he-projectile/PID_controller/Mechanics/3D_model/Фланец мотора.PNG

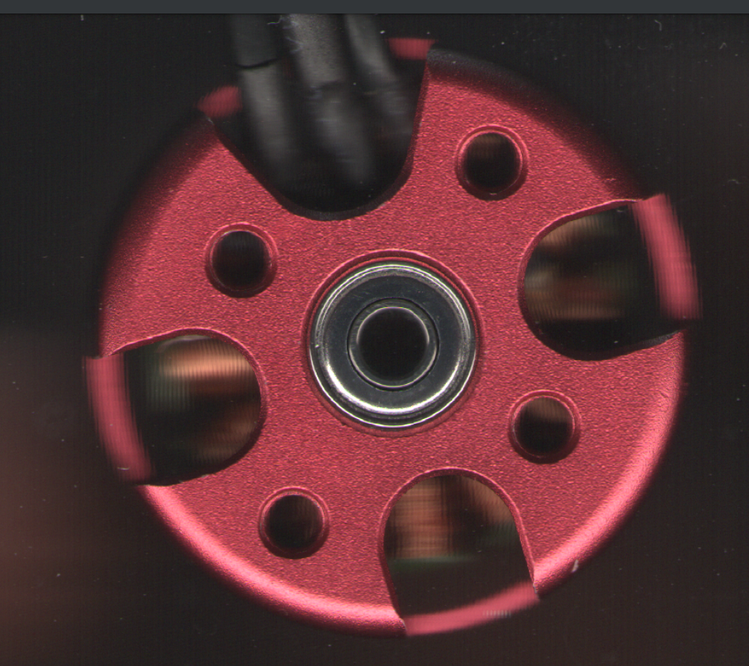
Mechanics/3D_model/Фланец мотора.PNG
