he-projectile/PID_controller/Mechanics/3D_model/Сборка.png

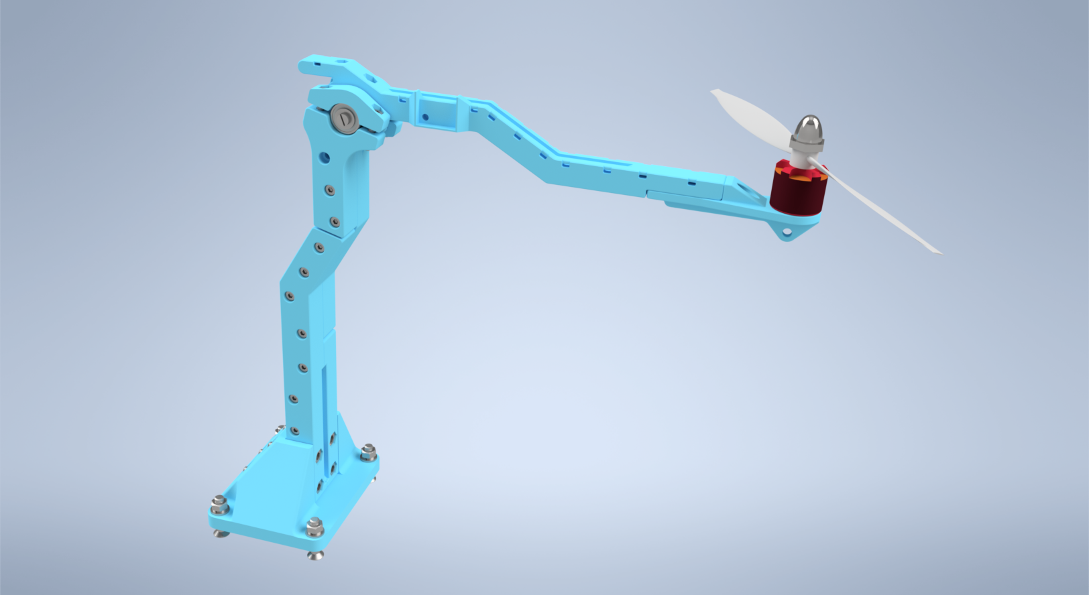
Mechanics/3D_model/Сборка.png
