he-projectile/PID_controller/Mechanics/3D_model/PID_demensions.xlsx

blade_radius | 127
blade_height | 10
bearing_inner | 7
bearing_outer | 19
bearing_width | 6
beam_length | 254
motor_height | 24
motor_diameter | 28
motor_blade_offset | 2
shaft_beam_diameter | 10
M4_screw_innerHex_cap_diam | 6.6
M4_screw_innerHex_cap_height | 4
M4_nut_lock_width | 6.8
M4_nut_lock_height | 5
