he-projectile/PID_controller/Mechanics/3D_model/пример 3д пдф.pdf

setPageBoxes("Crop", 0, 0, [0,2000,2000,0]);
Наименование НОМЕР ДЕТАЛИ | Сборка ВЕРСИЯ Разработал | barko Т. контр. ПРИМЕЧАНИЯ

ПРЕДСТАВЛЕННЫЕ СВЕДЕНИЯ И/ИЛИ МАТЕРИАЛЫ ЯВЛЯЮТСЯ СОБСТВЕННОСТЬЮ АВТОРА ОГРАНИЧЕННОГО ДОСТУПА. ЗАПРЕЩЕНО ИСПОЛЬЗОВАТЬ, ВОСПРОИЗВОДИТЬ, ПУБЛИКОВАТЬ ИЛИ РАСКРЫВАТЬ ЭТИ ДАННЫЕ БЕЗ ПИСЬМЕННОГО РАЗРЕШЕНИЯ. ОНИ ПРЕДНАЗНАЧЕНЫ ТОЛЬКО ДЛЯ РАБОТЫ С ЭЛЕМЕНТАМИ, УКАЗАННЫМИ В ДОКУМЕНТЕ.
