he-projectile/PID_controller/Статья/Ещё_один_пид_контроллеро (2)-теория.pdf

## Теория

В сегодняшней статье расскажу, как на стенде измеряется угол, чем обеспечивается защита от дурака, и как мне помог чатжипити.
Итак, рабочая часть стенда представляет собой неуравновешенную балку с мотором и датчиком, называемыми вместе лучом.Исходное состояние луча - висит вертикально вниз. Тяга пропеллера создаёт момент силы, вращающий луч против часовой стрелки. Примем это направление за положительное, ограниченное углом 170°. В этом диапазоне сила тяжести всегда вращает луч в отрицательном направлении.

Измерение угла
Первостепенная задача - измерение угла отклонения луча от исходной позиции. Затем нужно проверить, что луч вращается в вертикальной плоскости для предотвращения включения стенда в неправильном положении или выключения мотора при заваливании. Первую задачу можно решить при помощи энкодера на оси, а вторую -административно. Но у квадрокоптера нет энкодеров, а аварийные ситуации случаются самопроизвольно. Поэтому буду использовать инерциальный датчик MPU6050 в модуле GY-521.
В одной из статей (https://habr.com/ru/articles/759272/) я описал способ определения ориентации инерциального датчика. Она представляется в виде матрицы 3 × 3, в которой столбцы соответствуют осям датчика, а строки - проекции на север, запад и вертикаль. Казалось бы, прикрепи датчик к балке, посмотри направление оси

−→
z

′

, запомни направление

−→
y

′

, после поворота посчитай угол между прежним и текущим направлением. Но такой вариант доступен только при полной уверенности в том, что ось датчика

−→
z

′ параллельна оси луча, а я не стану гарантировать это.
Поэтому надо обобщить обе операции для случайного закрепления датчика. Как и раньше, алгоритм прототипируется в матлабе. МК обрабатывает данные датчика, вычисляет матрицу и отправляет её компьютеру по USB-CDC в виде массива из 9 байт. При запуске стенда луч неподвижнен. Программа запоминает изначальную ориентацию датчика (M1). Матрица вращается вокруг вектора −→a , и получается матрица M2. Этот вектор и является осью вращения, надо вычислить его. Что мы знаем об −→a ? Его проекции на M1 и M2 одинаковы, при этом матрицы связаны матрицей перехода:

Mtr = M2 · M⁻¹
1
То есть, при применении к −→a линейного оператора Mtr снова выходит −→a . Получается, что −→a является собственным вектором для матрицы перехода. Так как матрица имеет размерность 3, то и собственных векторов тоже 3. Как выбрать нужный? Посчитать

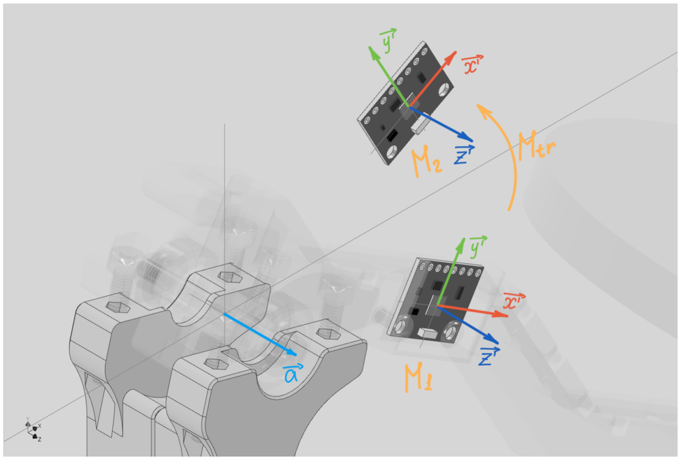
[picture p3: figure]

Рис. 6: Поворот датчика вокруг оси

собственные числа Mtr и выбрать вектор, соответсвующий λ = 1. Почему? Потому что собственное число - это скаляр, который растягивает собственный вектор. При повороте растяжения не происходит, значит λ = 1.
У этого решения есть несколько нюансов. Во-первых, погрешности измерений, расчётов и неровность механики приводят к тому, что Mtr не в полной мере является матрицей поворота, и λ ̸= 1. Поэтому приходится выбирать число наиболее близкое к 1, то есть, равное min(|λ − 1|). Во-вторых, вычисление собственных чисел матрицы - трудоёмкая задача как для микроконтроллера, так и для программиста. Прежде чем кинуться в написание сишных функций, я обратился за советом к чатужипити и не пожалел. Совет 1. Транспонировать матрицу вместо вычисления обратной. Для ортогональной матрицы, к которой относится матрица ориентации, M⁻¹ = MT

. Транспонировать
матрицу проще, и это снизит нагрузку на работу МК.
Совет 2. Использовать след матрицы поворота для вычисления угла.

tr(Mtr) = Mtr(11) + Mtr(22) + Mtr(33) = 1 + 2cos(ψ)

ψ = acos
tr(Mtr) − 1
2

ψ - угол поворота матрицы поворота.
Чтобы программа не ломалась, нужно ограничить значение tr(Mtr) отрезком [-1; 1]. Теоретически, значение следа не должно вылезать за эти границы, но увы, ошибки вычислений. Данный метод возвращает значения от 0 до π, но это не проблема для моего стенда.
Совет 3. Извлекать ось вращения из антисмимметричной части матрцы поворота.

−→a =

1
2sin(ψ)

·

Mtr(32) − Mtr(23)

Mtr(13) − Mtr(31)

Mtr(21) − Mtr(12)

Таким образом, вычисления угла и оси стали быстрыми и непринуждёнными. При запуске стенда необходимо перевести луч из нижнего положения в положение повыше. Из полученных данных будет вычислен вектор оси. Угол между осью и вертикалью должен иметь значение, близкое к 0, 5π. Сильное отклонение приведёт к переходу стенда в аварийное состояние и отключению мотора до перезапуска программы.

Симуляция работы
Прежде чем угробить стенд жёсткими режимами работы, хотелось бы поиграть в математическое моделирование. Может быть, я получу полезный практический опыт или даже готовые коэффициенты ПИД. Для этого составлю уравнение динамики стенда, наишу ПИД-реулатор для управления тягой, абстрагируюсь от задержки измерения угла и изменения тяги, инерции пропеллера.

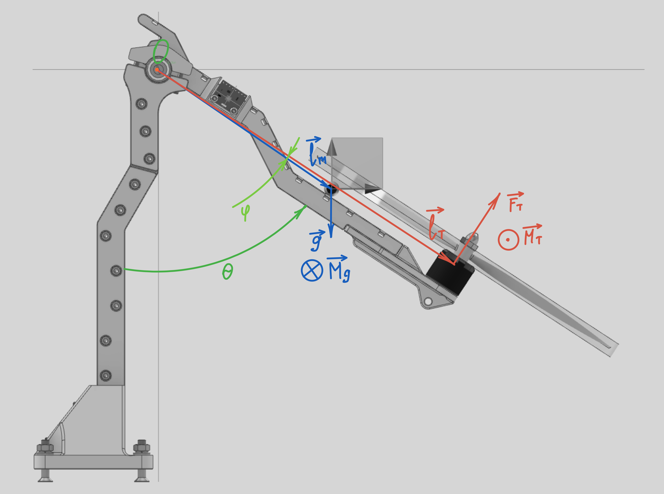
[picture p4: figure]

Рис. 7: Схема действия сил Сила тяжести, действующая на луч и приложенная к центру масс луча, создаёт момент, равный
−→Mg =

−→lg × m
−→g
или

Mg = m · g · lg · sin(θ − φ)
m - масса луча, lg - расстояние от оси O до центра масс луча, θ - угол отклонения луча, φ - угол между лучом и вектором до центра масс.
Так как отклонение луча ограничено 170°, направление момента не меняется. Уравнение статики для этой системы выглядит так:
−→Mg +

−→Mt = 0

или

FT · lT − m · g · lm · sin(θ − φ) = 0
lT - расстояние между осью луча и осью пропеллера, FT - сила тяги пропеллера. При дисбалансе сил возникает угловое ускорение:

FT · lT − m · g · lm · sin(θ − φ) J

= ¨θ

Необходимо добавить сопротивление среды. К ним можно отнести силу трения покоя в подшипнике, силу сухого трения подшипника, силу вязкого сопротивления смазки и силу сопротивления воздуха. Силу сухого трения и трения покоя я исключу, так как хорошо смазал подшипники вэдэшкой. Включим оставшиеся силы и получим уравнение динамики системы.

FT · lT − m · g · lm · sin(θ − φ) − kv

˙θ − ka

˙θ
2
- sign(

˙θ)

J

= ¨θ

J - момент инерции, kv - коэффициент вязкого сопротивления смазки, ka - коэффициент сопротивления воздуха.
Момент инерции и расстояние до центра масс вычислены в САПРе. Для этого я взвесил каждую деталь и прописал массу в физические свойства модели. Равномерность распределения массы по объёму является большим допущением для деталей, напечатанных на FDM-принтере, но это лучшее, что я смог реализовать.
kv и ka - эмпирические коэффициенты. Я получил их значения экспериментально. Для этого закрепил мачту горизонтально, отвёл луч, позволил ему свободно колебаться под действием силы тяжести и получил функцию затухающих колебаний в табличном виде θexp(t). При этом диффур обретает вид

−m·g·lm·sin(θ−φ)−kv

˙θ−ka

˙θ
2
·sign(

˙θ)
J | = ¨θ

θ(0) = −39◦
˙θ = 0
Затем написал матлаб-скрипт, численно решающий приведённый диффур с такими же начальными условиями, как у θexp(t). Обозначу вычисленные данные как θsim(t). Оба графика представлены на рисунке. Как можно увидеть, частоты значительно различаются, примерно в два раза. Она зависит от параметров lm и J. Подобрав ручками J, я понял, что увеличение его вдвое исправляет проблему. После проверки масс всех деталей, я вспомнил, что мой любимый САПР указывает момент инерции относительно центра масс. Чтобы пересчитать значения J для вращения вокруг O, нужно применить теорему Гюйгенса-Штейнера:
J = JC + m · l

2
m
где JC - момент инерции, рассчитанный САПРом.
Отклонение частоты после корректировки уменьшилось до 3%; Теперь можно подобрать kv и ka. Сделать это можно следующим способом. Так как диффур исчерпывающий, можно надеяться, что при правильном выборе kv и ka графики совпадут. Хорошо бы сделать подбор автоматическим и оптимальным по времени. Сперва нужно выбрать

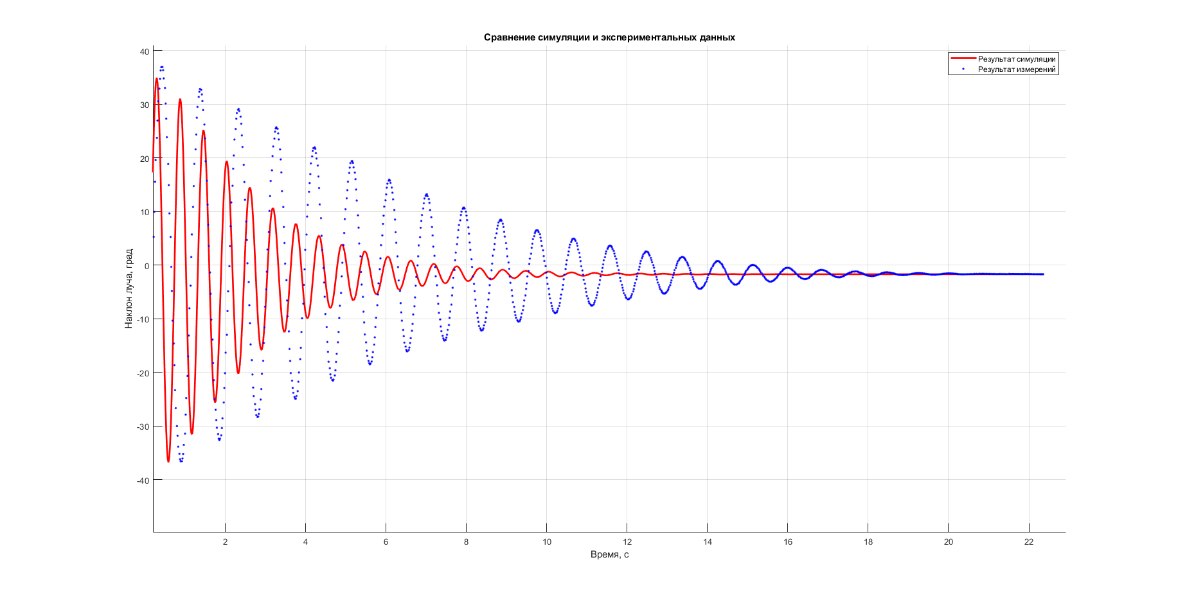
[picture p5: figure]

Рис. 8: Это фиаско

критерий совпадения графиков. Сумма квадратов невязок отлично подходит на роль меры.

RSS =

Xn

τ=0

(θsim(τ ) − θexp(τ ))²

Но вот незадача. Временные метки у θexp(t) и θsim(t) различаются, выбирать пары значений θ с одинаковым аргументом не получится. К тому же, частоты незначительно различаются, на шестнадцатом периоде колебания сдвинуты на 0, 5pi, поэтому RSS никогда не станет равным нулю ( И что? Обоснуй. Мб будет плохо сходиться. Почему?). Однако известно, что kv и ka характеризуют форму огибающей и практически не влияют на период колебаний. Значит можно сравнивать огибающие этих графиков. Для этого из θexp(t) и θsim(t) выделяются пики с помощью функции findpeaks, обозначенные γexp(t) и γsim(t). Затем надо интерполировать γsim(t) функцией interp1 методом сплайн и получить соответствующие значения для временных меток γexp(t). Теперь можно сравнить огибающие. Таким образом вычисление kv и ka сводится к минимизации функции RSS:
RSS(kv, ka) → min
ka,kv∈R²
Для этого используется функция fmincon из пакета Optimization Toolboxt. С начальным приближением kv = 0, ka = 0 решение заняло 16 итераций. Результат можно видеть на графике выше, а полученные значения в таблице.

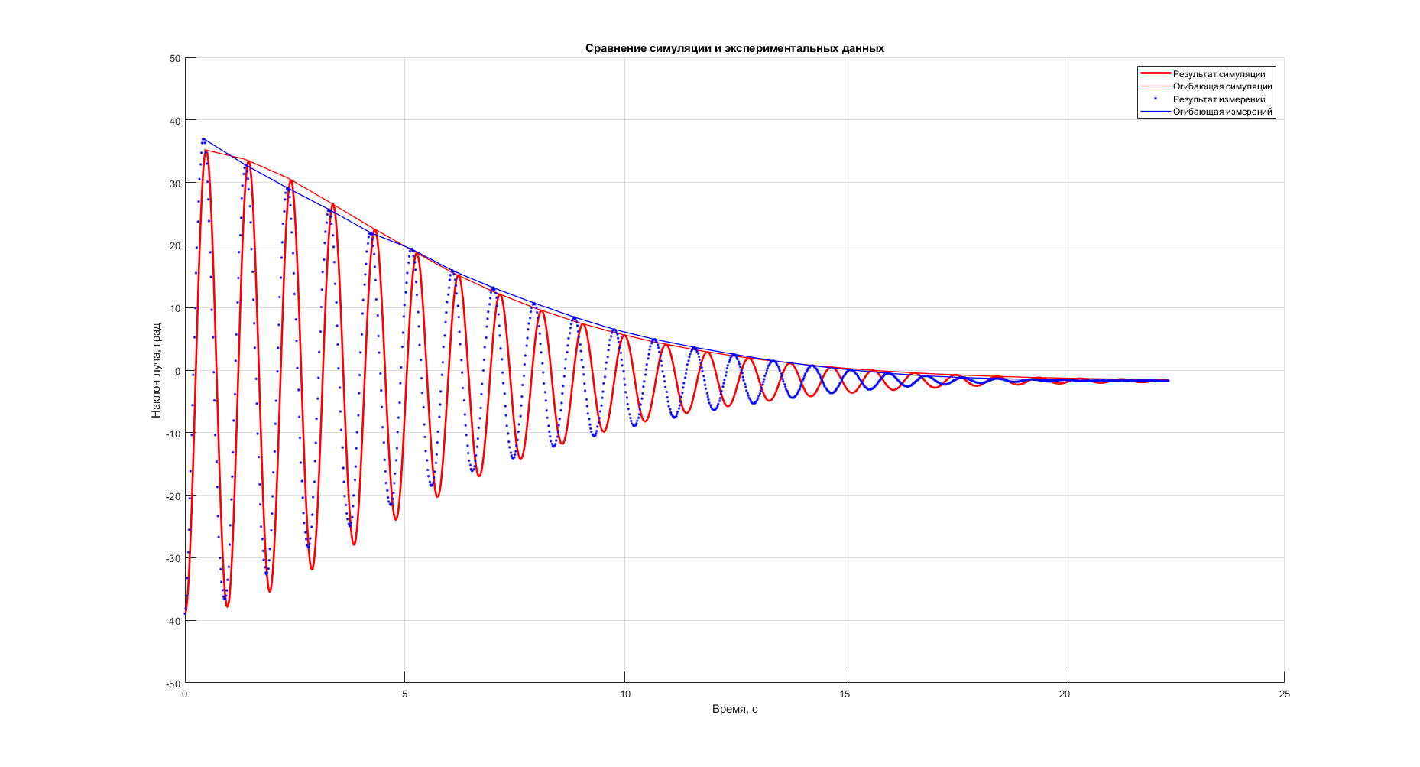
[picture p6: figure]

Рис. 9: Графики отлично накладываются

J, кг·м 2 | 5,52e-3
m, кг | 0,181
lm, м | 0,139
ψ, град | 1,71
kv, попугаи | 1,85e-3
ka, попугаи | 1,06t-3
Теперь можно приступить к моделированию PID-регулятора.
