he-projectile/PID_controller/Статья/Ещё_один_пид_контроллеро-теория.pdf

### Ещё один ПИД-регулятор

Даниил Барков

Лето 2025

## Теория

В сегодняшней статье расскажу, как на стенде измеряется угол, чем обеспечивается защита от дурака, и как мне помог чатжипити.
Итак, рабочая часть стенда представляет собой неуравновешенную балку с мотором и датчиком, называемыми вместе лучом.Исходное состояние луча - висит вертикально вниз. Тяга пропеллера создаёт момент силы, вращающий луч против часовой стрелки. Примем это направление за положительное, ограниченное углом 170°. В этом диапазоне сила тяжести всегда вращает луч в отрицательном направлении.

Измерение угла
Первостепенная задача - измерение угла отклонения луча от исходной позиции. Затем нужно проверить, что луч вращается в вертикальной плоскости для предотвращения включения стенда в неправильном положении или выключения мотора при заваливании. Первую задачу можно решить при помощи энкодера на оси, а вторую -административно. Но у квадрокоптера нет энкодеров, а аварийные ситуации случаются самопроизвольно. Поэтому буду использовать инерциальный датчик MPU6050 в модуле GY-521.
В одной из статей (https://habr.com/ru/articles/759272/) я описал способ определения ориентации инерциального датчика. Она представляется в виде матрицы 3 × 3, в которой столбцы соответствуют осям датчика, а строки - проекции на север, запад и вертикаль. Казалось бы, прикрепи датчик к балке, посмотри направление оси

−→
z

′

, запомни направление

−→
y

′

, после поворота посчитай угол между прежним и текущим направлением. Но такой вариант доступен только при полной уверенности в том, что ось датчика

−→
z

′ параллельна оси луча, а я не стану гарантировать это.
Поэтому надо обобщить обе операции для случайного закрепления датчика. Как и раньше, алгоритм прототипируется в матлабе. МК обрабатывает данные датчика, вычисляет матрицу и отправляет её компьютеру по USB-CDC в виде массива из 9 байт. При запуске стенда луч неподвижнен. Программа запоминает изначальную ориентацию датчика (M1). Матрица вращается вокруг вектора −→a , и получается матрица M2. Этот вектор и является осью вращения, надо вычислить его. Что мы знаем об −→a ? Его проекции на M1 и M2 одинаковы, при этом матрицы связаны матрицей перехода:

Mtr = M2 · M⁻¹
1
То есть, при применении к −→a линейного оператора Mtr снова выходит −→a . Получается, что −→a является собственным вектором для матрицы перехода. Так как матрица имеет размерность 3, то и собственных векторов тоже 3. Как выбрать нужный? Посчитать


Рис. 6: Поворот датчика вокруг оси

собственные числа Mtr и выбрать вектор, соответсвующий λ = 1. Почему? Потому что собственное число - это скаляр, который растягивает собственный вектор. При повороте растяжения не происходит, значит λ = 1.
У этого решения есть несколько нюансов. Во-первых, погрешности измерений, расчётов и неровность механики приводят к тому, что Mtr не в полной мере является матрицей поворота, и λ ̸= 1. Поэтому приходится выбирать число наиболее близкое к 1, то есть, равное min(|λ − 1|). Во-вторых, вычисление собственных чисел матрицы - трудоёмкая задача как для микроконтроллера, так и для программиста. Прежде чем кинуться в написание сишных функций, я обратился за советом к чатужипити и не пожалел. Совет 1. Транспонировать матрицу вместо вычисления обратной. Для ортогональной матрицы, к которой относится матрица ориентации, M⁻¹ = MT

. Транспонировать
матрицу проще, и это снизит нагрузку на работу МК.
Совет 2. Использовать след матрицы поворота для вычисления угла.

tr(Mtr) = Mtr(11) + Mtr(22) + Mtr(33) = 1 + 2cos(ψ)

ψ = acos
tr(Mtr) − 1
2

ψ - угол поворота матрицы поворота.
Чтобы программа не ломалась, нужно ограничить значение tr(Mtr) отрезком [-1; 1]. Теоретически, значение следа не должно вылезать за эти границы, но увы, ошибки вычислений. Данный метод возвращает значения от 0 до π, но это не проблема для моего стенда.
Совет 3. Извлекать ось вращения из антисмимметричной части матрцы поворота.

−→a =

1
2sin(ψ)

·

Mtr(32) − Mtr(23)

Mtr(13) − Mtr(31)

Mtr(21) − Mtr(12)

Таким образом, вычисления угла и оси стали быстрыми и непринуждёнными. При запуске стенда необходимо перевести луч из нижнего положения в положение повыше. Из полученных данных будет вычислен вектор оси. Угол между осью и вертикалью должен иметь значение, близкое к 0, 5π. Сильное отклонение приведёт к переходу стенда в аварийное состояние и отключению мотора до перезапуска программы.

Расчёт параметров модели
Прежде чем угробить стенд жёсткими режимами работы, хотелось бы поиграть в математическое моделирование. Может быть, я получу полезный практический опыт или даже готовые коэффициенты ПИД. Для этого составлю уравнение динамики стенда, наишу ПИД-реулатор для управления тягой, абстрагируюсь от задержки измерения угла и изменения тяги, инерции пропеллера.


Рис. 7: Схема действия сил Сила тяжести, действующая на луч и приложенная к центру масс луча, создаёт момент, равный
−→Mg =

−→lg × m
−→g
или

Mg = m · g · lg · sin(θ − φ)
m - масса луча, lg - расстояние от оси O до центра масс луча, θ - угол отклонения луча, φ - угол между лучом и вектором до центра масс.
Так как отклонение луча ограничено 170°, направление момента не меняется. Уравнение статики для этой системы выглядит так:
−→Mg +

−→Mt = 0

или

0 = FT · lT − m · g · lm · sin(θ − φ)
lT - расстояние между осью луча и осью пропеллера, FT - сила тяги пропеллера. При дисбалансе сил возникает угловое ускорение:

¨θ =

FT · lT − m · g · lm · sin(θ − φ) J
Необходимо добавить сопротивление среды. К ним можно отнести силу трения покоя в подшипнике, силу сухого трения подшипника, силу вязкого сопротивления смазки и силу сопротивления воздуха. Силу сухого трения и трения покоя я исключу, так как хорошо смазал подшипники вэдэшкой. Включим оставшиеся силы и получим уравнение динамики системы.

¨θ =

FT · lT − m · g · lm · sin(θ − φ) − kv

˙θ − ka

˙θ
2
- sign(

˙θ)

J
J - момент инерции, kv - коэффициент вязкого сопротивления смазки, ka - коэффициент сопротивления воздуха.
Момент инерции и расстояние до центра масс вычислены в САПРе. Для этого я взвесил каждую деталь и прописал массу в физические свойства модели. Равномерность распределения массы по объёму является большим допущением для деталей, напечатанных на FDM-принтере, но это лучшее, что я смог реализовать.
kv и ka - эмпирические коэффициенты. Я получил их значения экспериментально. Для этого закрепил мачту горизонтально, отвёл луч, позволил ему свободно колебаться под действием силы тяжести и получил функцию затухающих колебаний в табличном виде θexp(t). При этом диффур обретает вид

¨θ = (−m · g · lm · sin(θ − φ) − kv

˙θ − ka

˙θ
2
- sign(

˙θ)) · J
−1
θ(0) = −39◦
˙θ = 0

Затем написал матлаб-скрипт, численно решающий приведённый диффур с такими же начальными условиями, как у θexp(t). Обозначу вычисленные данные как θsim(t). Оба графика представлены на рисунке. Как можно увидеть, частоты значительно различаются, примерно в два раза. Она зависит от параметров lm и J. Подобрав ручками J, я понял, что увеличение его вдвое исправляет проблему. После проверки масс всех деталей, я вспомнил, что мой любимый САПР указывает момент инерции относительно центра масс. Чтобы пересчитать значения J для вращения вокруг O, нужно применить теорему Гюйгенса-Штейнера:
J = JC + m · l

2
m
где JC - момент инерции, рассчитанный САПРом.
Отклонение частоты уменьшилось до 3%. Теперь можно подобрать kv и ka. Сделать это можно следующим способом. Так как диффур исчерпывающий, можно надеяться, что


Рис. 8: Это фиаско

при правильном выборе kv и ka графики совпадут. Хорошо бы сделать подбор автоматическим и оптимальным по времени. Сперва нужно выбрать критерий совпадения графиков. Сумма квадратов невязок отлично подходит на роль меры.

RSS(kv, ka) = X

N

i=0

(θsim(ti

, kv, ka) − θexp(ti))²

Но вот незадача. Временные метки у θexp(t) и θsim(t) различаются, выбирать пары значений θ с одинаковым аргументом не получится. К тому же, частоты незначительно различаются, на шестнадцатом периоде колебания сдвинуты на 0, 5π, поэтому RSS никогда не станет равным нулю ( И что? Обоснуй. Мб будет плохо сходиться. Почему?). Однако известно, что kv и ka характеризуют форму огибающей и практически не влияют на период колебаний. Значит, достаточно сравнивать огибающие этих графиков. Для этого из θexp(t) и θsim(t) выделяются пики с помощью функции findpeaks, обозначенные γexp(t) и γsim(t). Затем надо интерполировать γsim(t) функцией interp1 методом сплайн, подставить временные метки из θexp(t) и получить соответствующие значения γsimInt(t). Теперь можно сравнить огибающие. Таким образом вычисление kv и ka сводится к минимизации функции RSS:

RSS(kv, ka) = X

N

i=0

(γsimInt(ti

, kv, ka) − γexp(ti))² → min
ka,kv∈R²
Для этого используется функция fmincon из пакета Optimization Toolboxt. С начальным приближением kv0 = 0, ka0 = 0 решение заняло 16 итераций. Результат можно видеть на графике выше, а полученные значения в таблице.


Рис. 9: Графики отлично накладываются

J, кг·м 2 | 5,52e-3
m, кг | 0,181
lm, м | 0,139
ψ, град | 1,71
kv, попугаи | 1,85e-3
ka, попугаи | 1,06е-3

Симуляция PID-регулятора
Наконец, можно приступить к моделированию PID-регулятора. Ограничу задачу достижением и поддержанием угла луча, но в будущем попробую также регулировать скорость вращения луча.
Итак, формула PID-регулятора всем известна.
(
u(t) = KP · err(t) + KI ·

R t
0

err(τ ) dτ − KD ·

derr(t)
dt
err(t) = θset − θ(t)
θset - установочное значение, к которому стремится θ(t). err(t) - ошибка регулирования. u(t) - управляющее воздействие, стремящееся уменьшить ошибку. KP , KI , KD - коэффициенты при пропорциональной, интегральной и дифференциальной составляющей регулятора соответственно. Их значения и определяют работу регулятора, их и предстоит подобрать.

Сперва необходимо врезать в диффур PID-регулятор.

¨θ(t) = (Fmax · u(t) · lT − m · g · lm · sin(θ(t) − φ) − kv ˙θ(t) − ka
˙θ
2
(t) · sign(

˙θ(t))) · J
−1

u(t) ∈ [0, 1]
˙θ(0) = 0

θ(0) = θ0
Fmax - максимальная тяга, которую может выдать мотор. θ0 - Начальный угол Регулятор управляет тягой, которая может быть только положительной и имеет ограничение сверху. Поэтому удобно ограничить также управляющий параметр u(t). Для решения диффура необходимо принять начальные условия ˙θ(0) и θ(0). Регулятор начинает работу при неподвижном опущенном луче, поэтому они равны нулю.
Это дифференциальное уравнение не решается аналитически. Хорошо, что Матлаб может решить его численно. Скрипт выглядит так:
1 | % Parameters
2 | l_m = norm ([138.760 -4.145 ]) /1000*1; | % Distance to the center of
masses (m)
3 | m = 0.181; | % Mass (kg)
4 | psi = atan2 ( -4.145 , 138.760) ; % Rad
5 | J = 2036.662 /10^6+ m * l_m ^2; % kg*m^2
6 | g = 9.81; % m/s^2
7 | kv = 0.0001850;
8 | ka = 0.0001058;
9 | l_T = 0.254;
10 | F_T =10;
11 | alpha = deg2rad (90) ;

12
13 | % Initial conditions
14 | O0 = deg2rad (0) ; | % Initial angle (30 degrees )
15 | omega0 = 0; | % initial angular velocity
16 | integral0 = 0;
17 | Y0 = [ O0 ; omega0 ; integral0 ];

18
19 | % time span
20 | tspan = [0 10];

21
22 | % Solution
23 | [t , Y ] = ode45 ( @ (t , Y ) pendulumODE (t , Y , l_m , m , g , J , psi , kv , ka , F_T ,
l_T , alpha , 0.3 , 0.5 , 0.05 , 0.09) , tspan , Y0 ) ;

24
25 | % Graphics
26 | figure (1) ;
27 | clf ( figure (1) )

28
29 | plot (t , rad2deg ( Y (: ,1) ) , ’r’, ’LineWidth ’, 1.5) ;
30 | xlabel (’Time (c)’) ;
31 | ylabel (’Angle theta ( degree )’) ;
32 | title (’Anle dynamisc ’) ;
33 | ylim ([0 120])
34 | grid on ;
36 | yline ( rad2deg ( alpha ) )

37
38 function dYdt = pendulumODE (t , Y , l , m , g , J , psi , kv , ka , F_T , l_T , alpha , Kp , Ki , Kd , Ks )
39 | if Y (1) >= 0.99* pi
40 | Y (2) = 0;
41 | Y (1) = 0.99* pi;
42 | end
43 | O = Y (1) ; | % Angle theta
44 | omega = Y (2) ; | % Angular velocity dO/dt
45 | e = ( alpha - O ) ;

46
47 | d_integral = e ;

48
49 | if Y (3) >10
50 | Y (3) = 10;
51 | end
52 | if Y (3) < -10
53 | Y (3) = -10;
54 | end
55 | integral = Y (3) ;

56
57 | U = Kp * e+ Ki * integral - Kd * omega + Ks * sin ( alpha ) ;

58
59 | if U >1
60 | U = 1;
61 | end
62 | if U < 0.001
63 | U = 0.001;
64 | end
65 | F = F_T *U ;

66
67 | domegadt = ( F * l_T - m * g * l * sin (O - psi ) - kv * omega *t - ka * omega ^2* sign ( omega ) * t
) / J ;

68
69 | dYdt = [ omega ; domegadt ; d_integral ]; | % Returns vector of derivatives
70 | end
Функция ode45 решает диффур итерациями, поэтому на каждом шаге можно выполнять математические операции над переменными, сравнивать и менять их значения. Это позволяет встроить в диффур различные проверки. Например, на строках 59-64 реализовано ограничение управляющего параметра.
Пора перейти к подбору коэффициентов. Для этого надо
