he-projectile/PID_controller/Mechanics/3D_model/Спецификация.xlsx

Номер | Обозначение | Единичная величина | КОЛ. | Инвентарный номер | Описание | ИЗМ.
8 | Гайка M4-6H ГОСТ 15524-70 | 1 | 7 |  | Гайки шестигранные высокие класса точности А
9 | Винт M4-6gx20 ГОСТ 11738-84 | 1 | 2 |  | ВИНТЫ С ЦИЛИНДРИЧЕСКОЙ ГОЛОВКОЙ И ШЕСТИГРАННЫМ УГЛУБЛЕНИЕМ ПОД КЛЮЧ КЛАССА ТОЧНОСТИ А
11 | Гайка M6-6H ГОСТ 5915-70(1) | 1 | 8 |  | Гайки шестигранные класса точности B удалены и заменены на гайки ГОСТ ISO 4032-2014 и гайки ГОСТ ISO 8673-2014
12 | Винт M6-6gx50 ГОСТ 11738-84 | 1 | 2 |  | ВИНТЫ С ЦИЛИНДРИЧЕСКОЙ ГОЛОВКОЙ И ШЕСТИГРАННЫМ УГЛУБЛЕНИЕМ ПОД КЛЮЧ КЛАССА ТОЧНОСТИ А
13 | Шайба 6 ГОСТ 11371-78 | 1 | 4 |  | ШАЙБЫ
14 | Шайба 6Л ГОСТ 6402-78 | 1 | 4 |  | Шайбы пружинные
15 | Винт 2.M6-6gx30 ГОСТ 17475-80 | 1 | 4 |  | ВИНТЫ С ПОТАЙНОЙ ГОЛОВКОЙ КЛАССОВ ТОЧНОСТИ А И В
16 | ISO 10642 - M3x12 | 1 | 2 |  | Винты с потайной головкой с шестигранным углублением
17 | ISO 10642 - M3x8 | 1 | 4 |  | Винты с потайной головкой с шестигранным углублением
19 | Гайка M4-6H ГОСТ 11860-85 | 1 | 1 |  | ГАЙКИ КОЛПАЧКОВЫЕ КЛАССА ТОЧНОСТИ А
20 | Шайба A 4 ГОСТ 6958-78 | 1 | 2 |  | ШАЙБЫ УВЕЛИЧЕННЫЕ КЛАССЫ ТОЧНОСТИ А И С
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
