he-projectile/PID_controller/Matlab/PID model.bmp

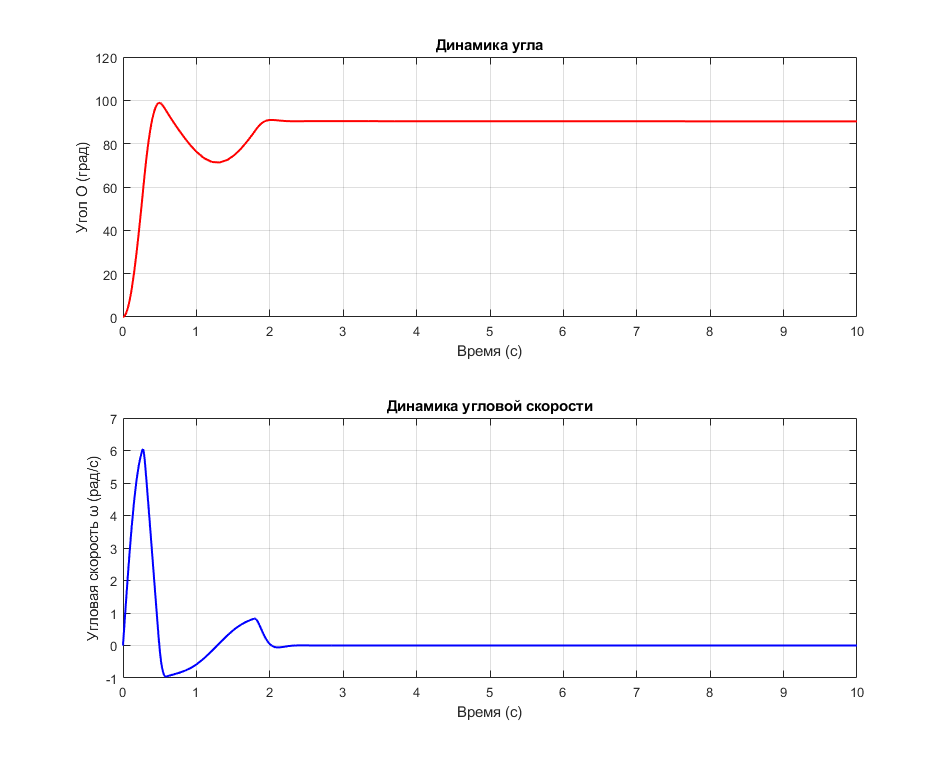
Matlab/PID model.bmp
