he-projectile/PID_controller/Matlab/Диаграмма.PNG

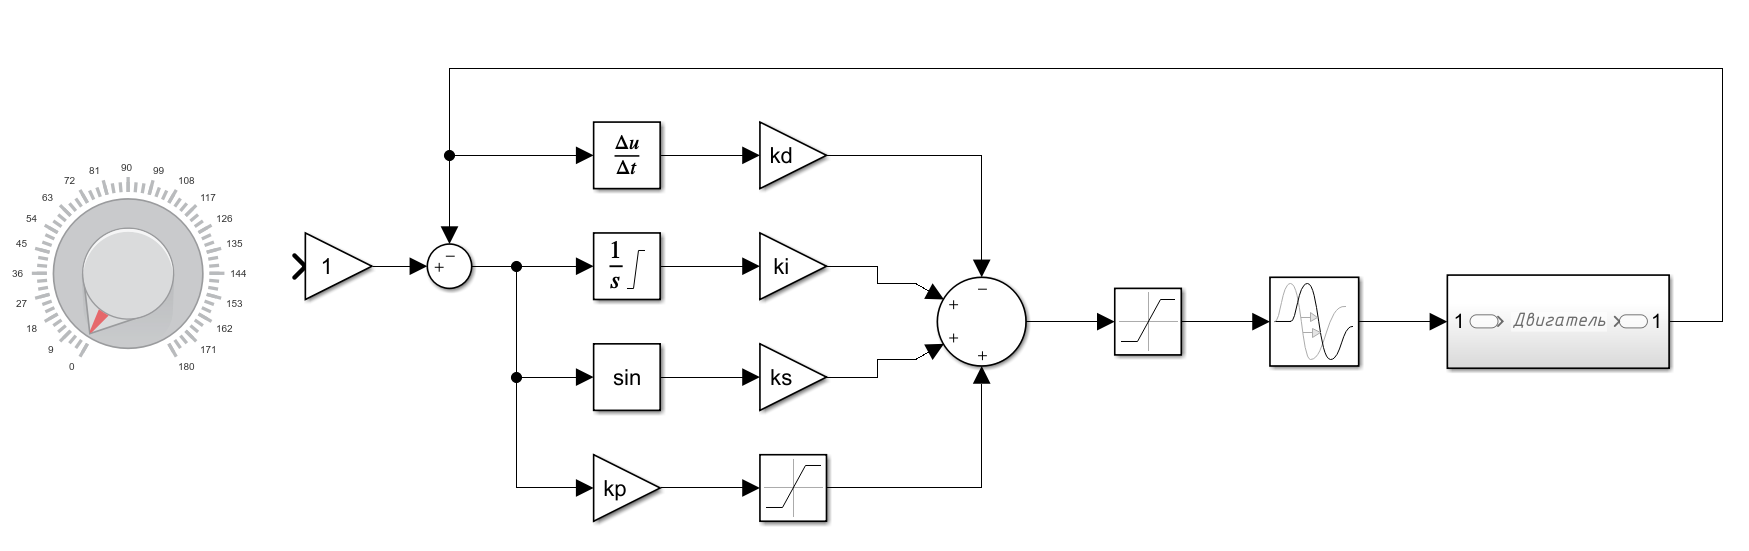
Matlab/Диаграмма.PNG
