he-projectile/PID_controller/Статья/ChatGPT Image 12 июл. 2025 г., 18_17_30.png

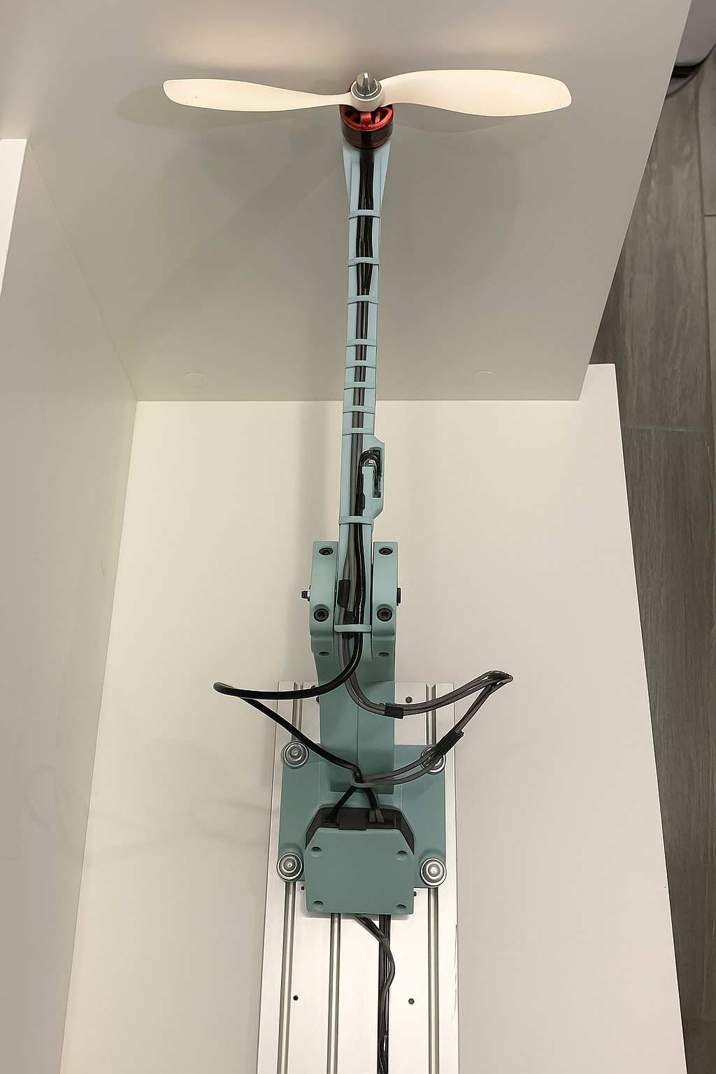
Статья/ChatGPT Image 12 июл. 2025 г., 18_17_30.png
