he-projectile/PID_controller/Статья/PIDfirg.jpg

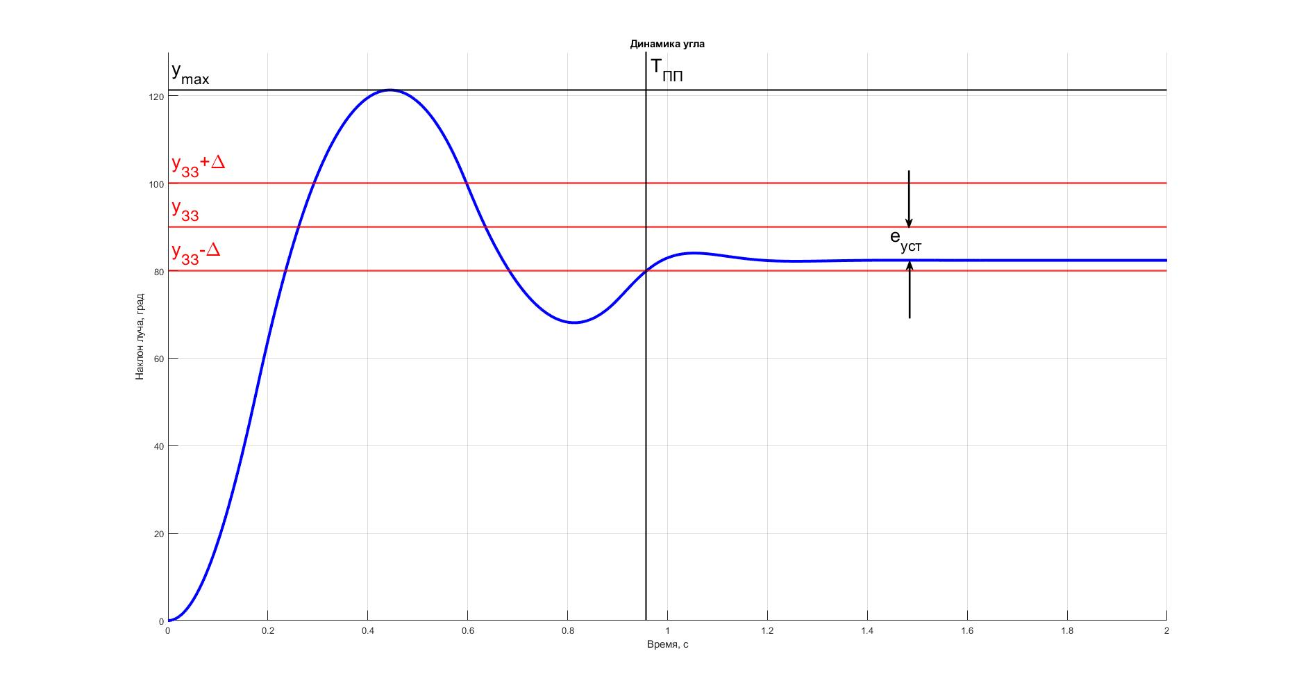
Статья/PIDfirg.jpg
