he-projectile/PID_controller/Статья/Втулка для подшипника.png

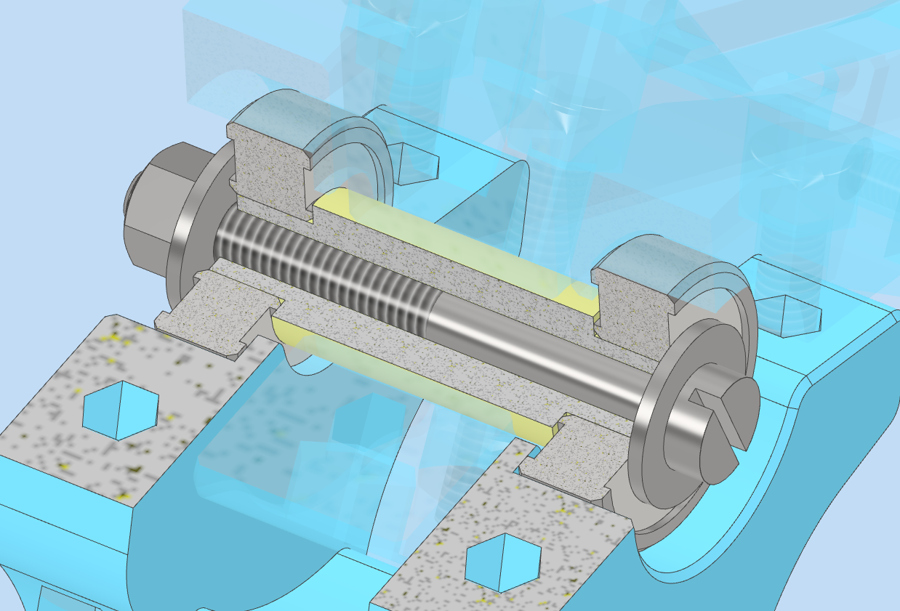
Статья/Втулка для подшипника.png
