he-projectile/PID_controller/Статья/Мемы/kortikozaporot1.jpg

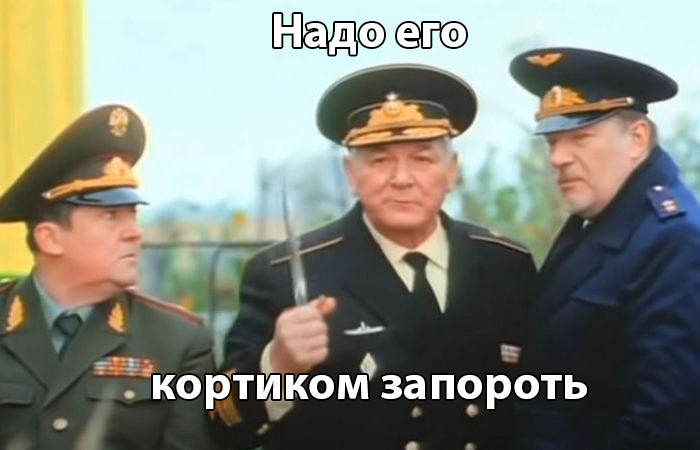
Статья/Мемы/kortikozaporot1.jpg
