he-projectile/PID_controller/Статья/Отверстия для винтов.png

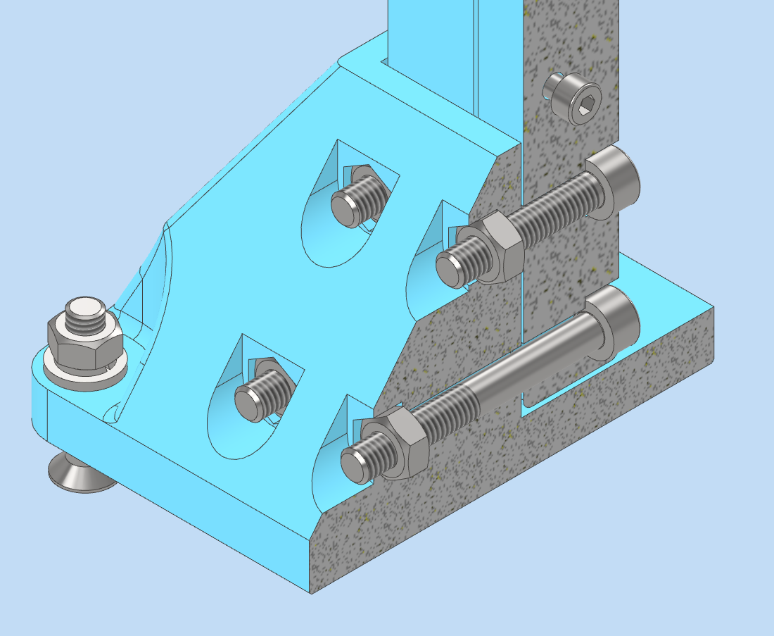
Статья/Отверстия для винтов.png
