he-projectile/PID_controller/Статья/Положение 1 ЧБ.png

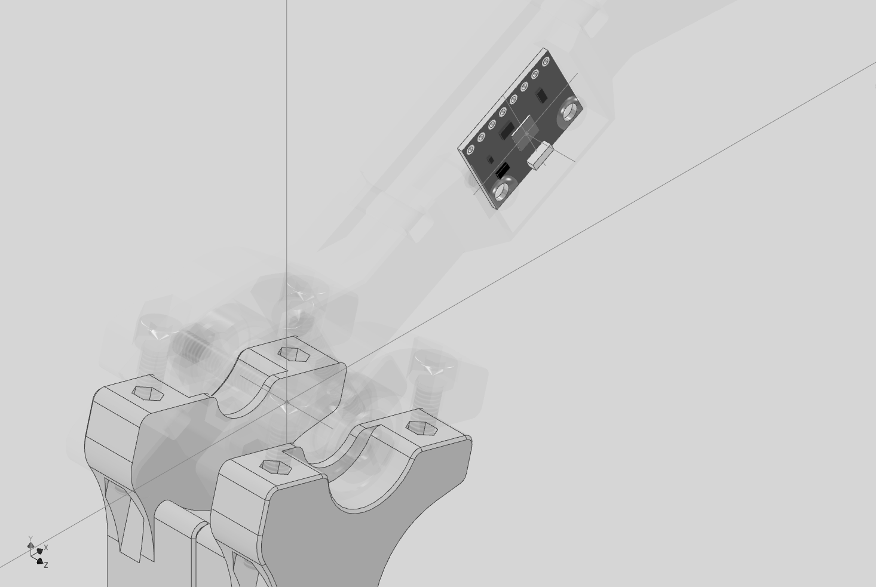
Статья/Положение 1 ЧБ.png
