he-projectile/PID_controller/Статья/Положение 2 ЧБ.png

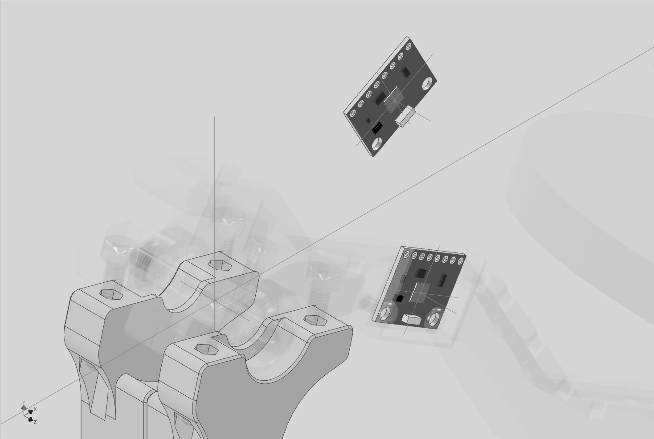
Статья/Положение 2 ЧБ.png
