he-projectile/PID_controller/Статья/Проводка/IMG_0525.JPG

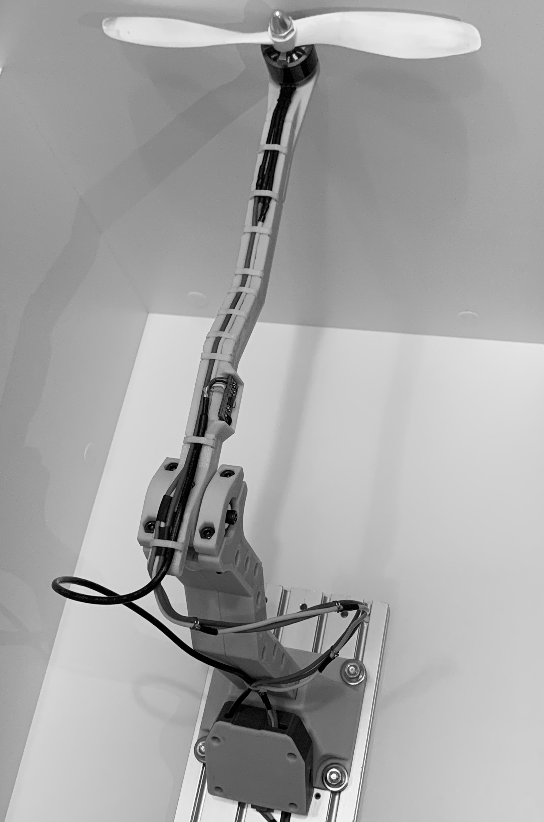
Статья/Проводка/IMG_0525.JPG
