he-projectile/PID_controller/Статья/Проводка/IMG_0526.JPG

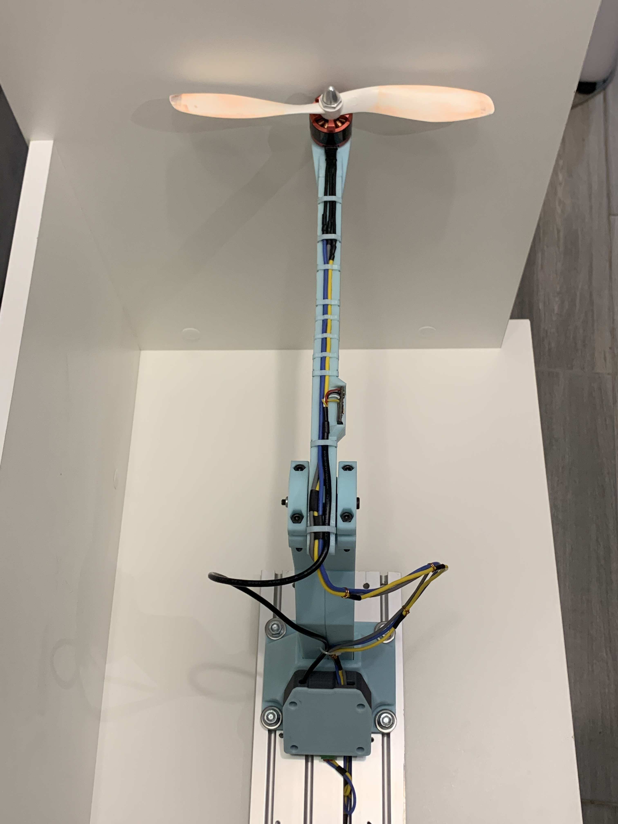
Статья/Проводка/IMG_0526.JPG
