he-projectile/PID_controller/Статья/Проводка/IMG_0527.JPG

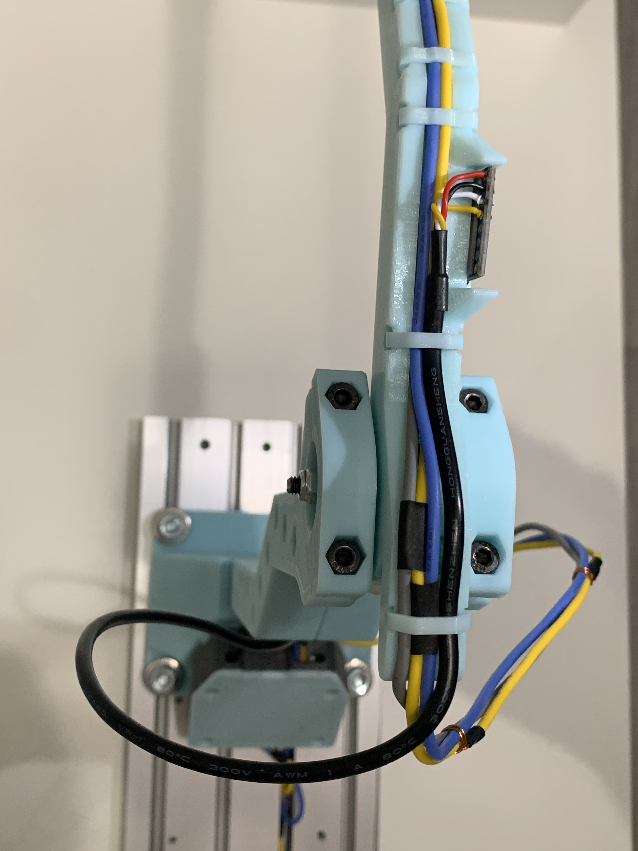
Статья/Проводка/IMG_0527.JPG
