he-projectile/PID_controller/Статья/Проводка/IMG_0528.JPG

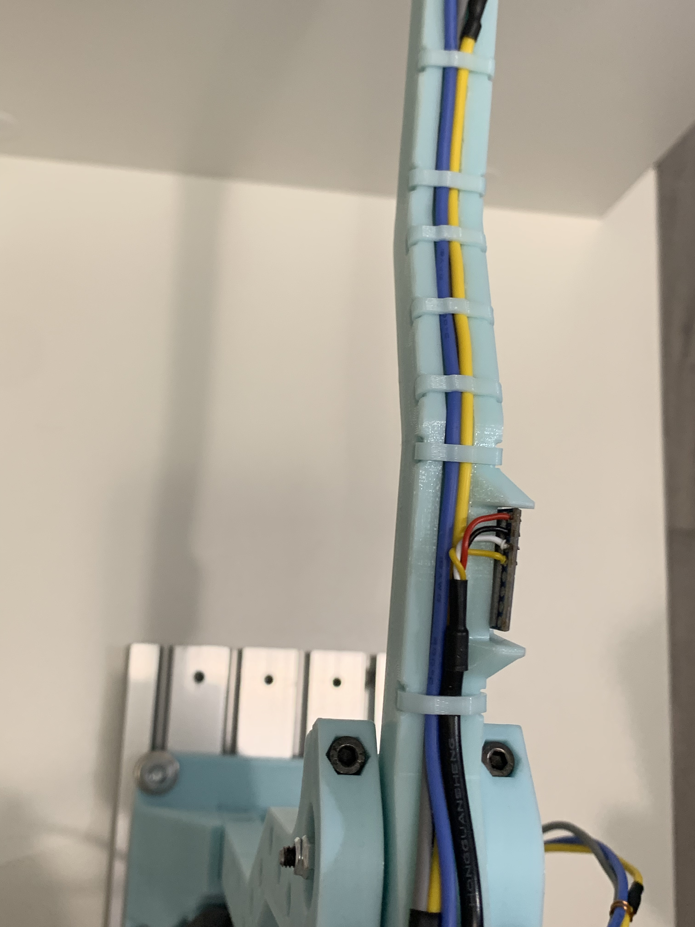
Статья/Проводка/IMG_0528.JPG
