he-projectile/PID_controller/Статья/Проводка/IMG_0529.JPG

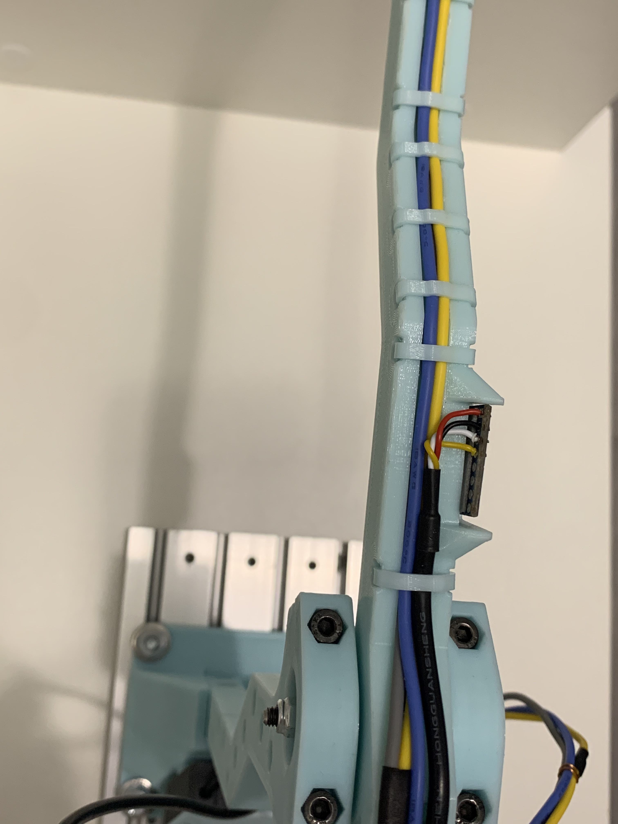
Статья/Проводка/IMG_0529.JPG
