he-projectile/PID_controller/Статья/Проводка/IMG_0530.JPG

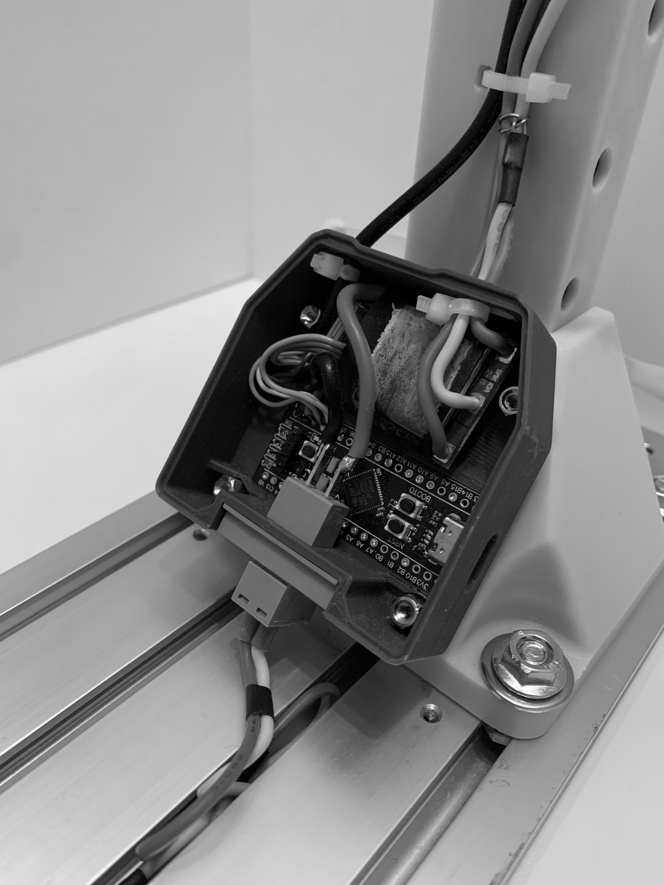
Статья/Проводка/IMG_0530.JPG
