he-projectile/PID_controller/Статья/Результат эскиза.png

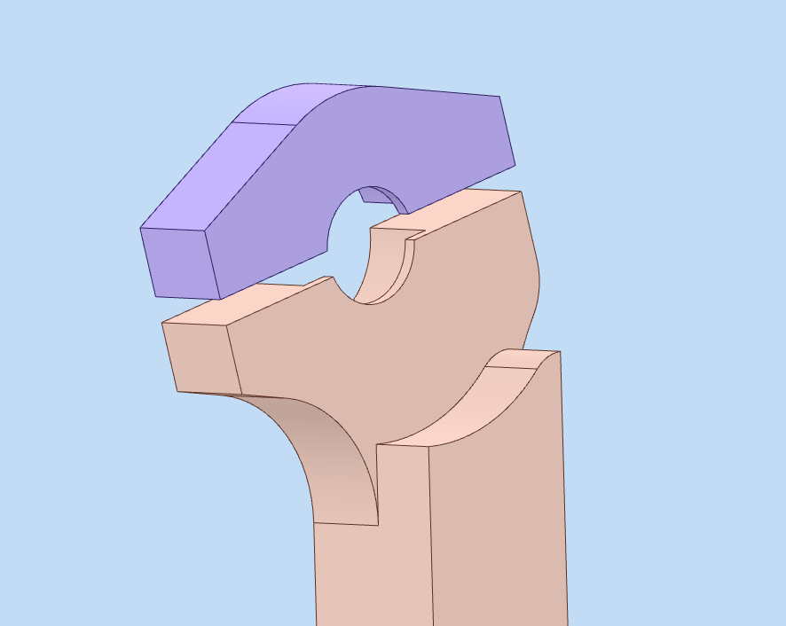
Статья/Результат эскиза.png
