he-projectile/PID_controller/Статья/Сложный эскизpng.png

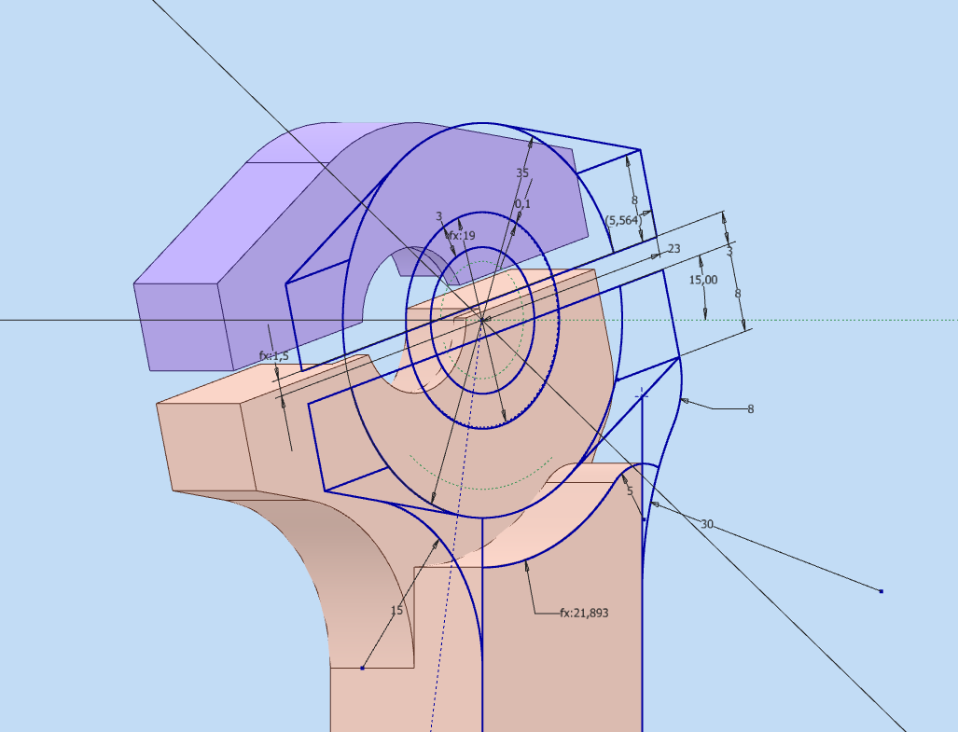
Статья/Сложный эскизpng.png
