he-projectile/PID_controller/Статья/Характеристики процесса.png

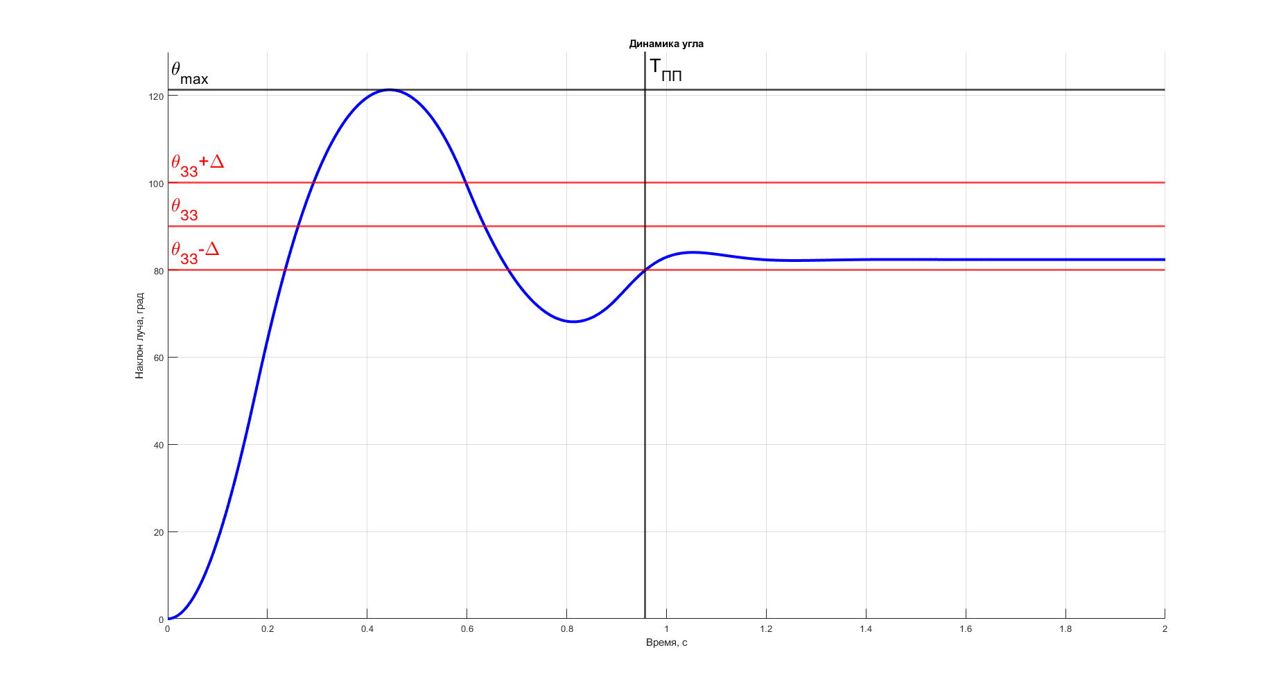
Статья/Характеристики процесса.png
