he-projectile/PID_controller/Статья/Хороший процесс.png

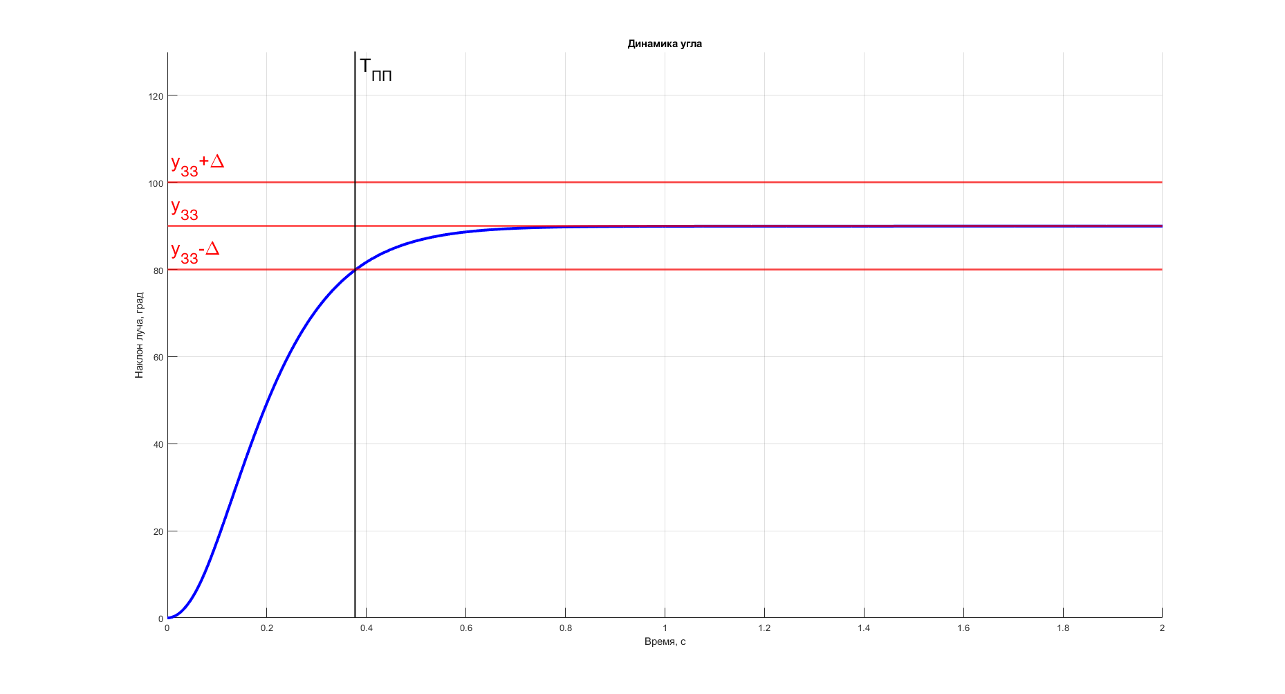
Статья/Хороший процесс.png
