he-projectile/PID_controller/Статья/Эскиз.png

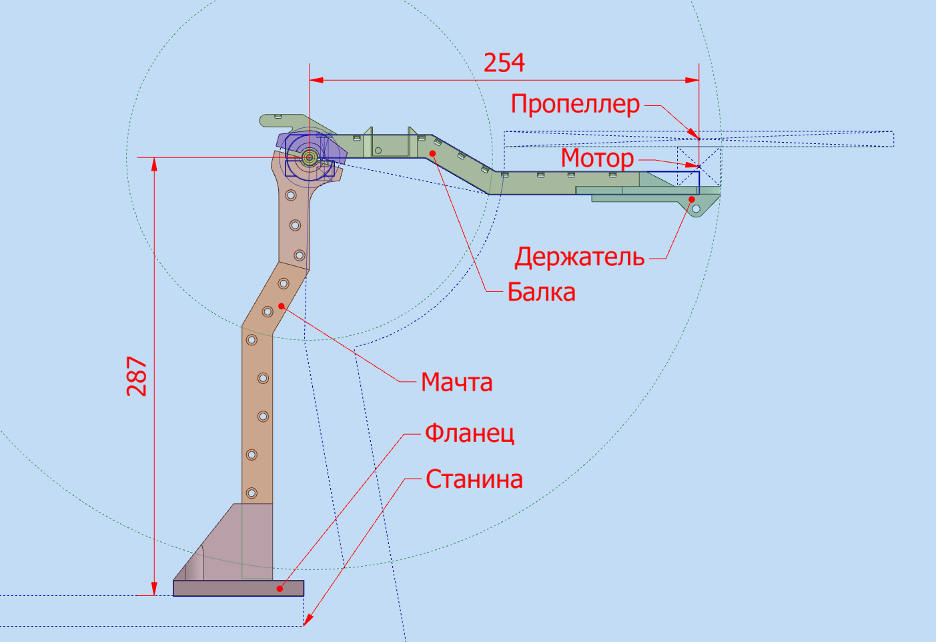
Статья/Эскиз.png
