he-projectile/PID_controller/Matlab/stlModels/stand.stl

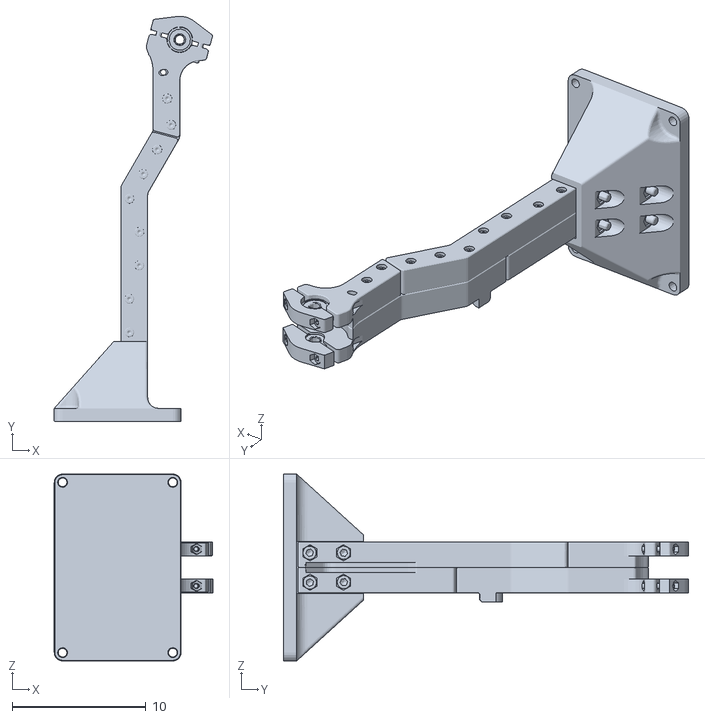
[picture p33: CAD file, 2025-01-03]
Matlab/stlModels/stand.stl
11.9 x 30.3 x 14.0
