he-projectile/PID_controller/Mechanics/3D_model/Файлы печати/Ножка правая низ.stl

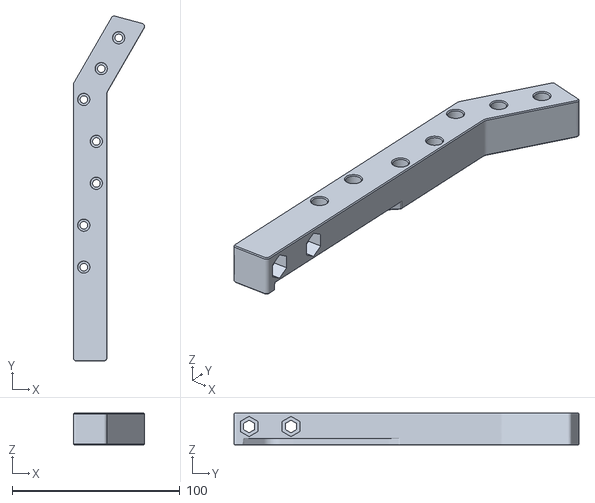
[picture p34: CAD file, 2025-02-20]
Mechanics/3D_model/Файлы печати/Ножка правая низ.stl
42.5 x 205.8 x 19.0
