he-projectile/PID_controller/Mechanics/3D_model/Файлы печати/Ножка правая верх.stl

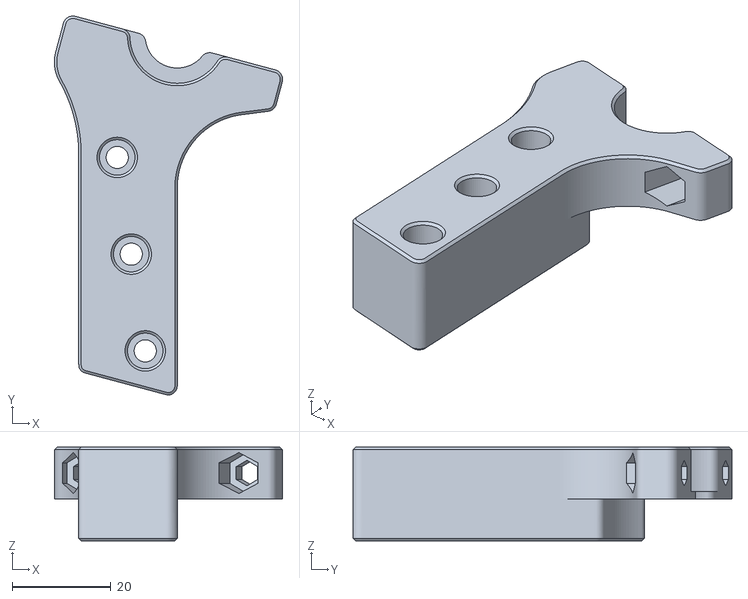
[picture p35: CAD file, 2025-02-20]
Mechanics/3D_model/Файлы печати/Ножка правая верх.stl
46.3 x 76.9 x 19.0
