he-projectile/PID_controller/Mechanics/3D_model/Файлы печати/Ножка левая верх.stl

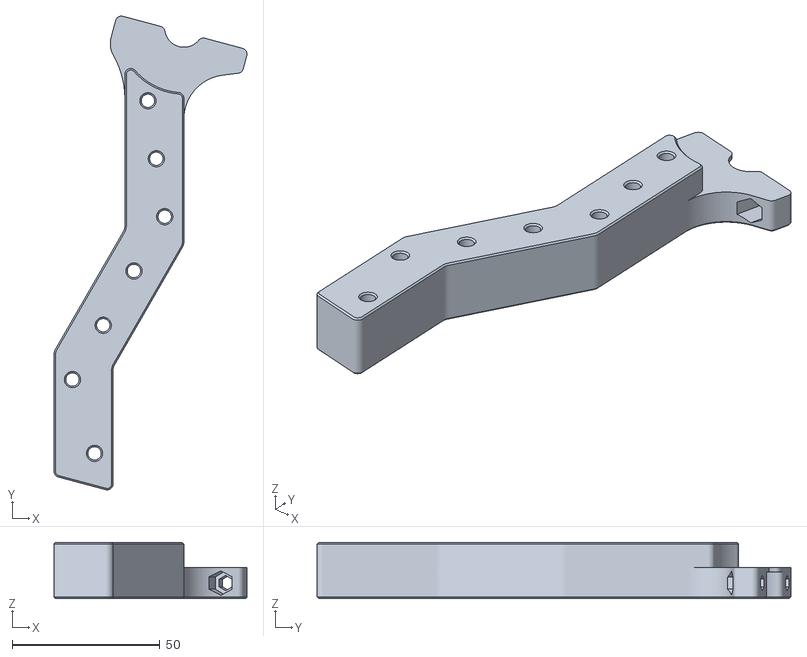
[picture p36: CAD file, 2025-02-20]
Mechanics/3D_model/Файлы печати/Ножка левая верх.stl
65.4 x 160.5 x 19.0
