he-projectile/PID_controller/Mechanics/3D_model/Файлы печати/Вал насадка 1.stl

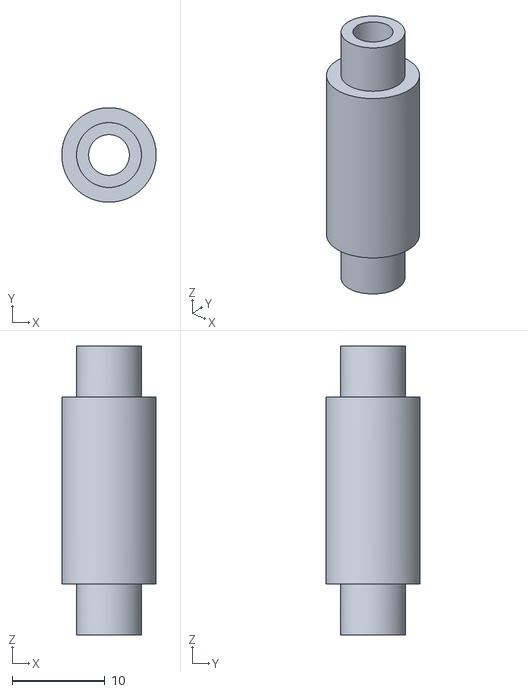
[picture p37: CAD file, 2025-02-20]
Mechanics/3D_model/Файлы печати/Вал насадка 1.stl
10.2 x 10.2 x 31.2
