he-projectile/PID_controller/Mechanics/3D_model/Файлы печати/Луч.stl

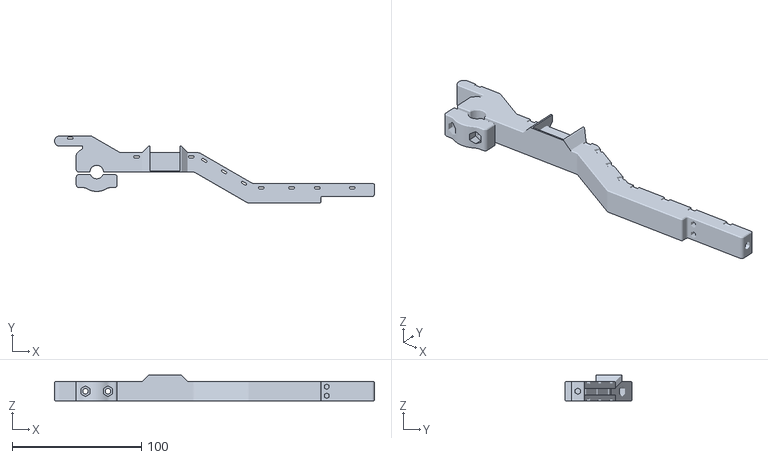
[picture p38: CAD file, 2025-02-20]
Mechanics/3D_model/Файлы печати/Луч.stl
247.7 x 52.0 x 20.0
