he-projectile/PID_controller/Mechanics/3D_model/Файлы печати/Ножка левая низ.stl

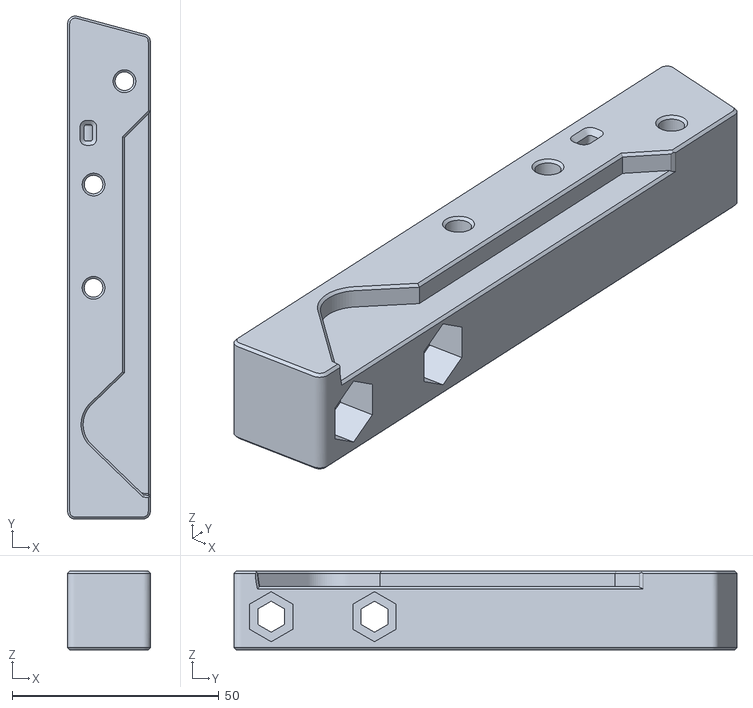
[picture p39: CAD file, 2025-02-20]
Mechanics/3D_model/Файлы печати/Ножка левая низ.stl
20.0 x 121.7 x 19.0
