he-projectile/PID_controller/Mechanics/3D_model/Файлы печати/Ложечка.stl

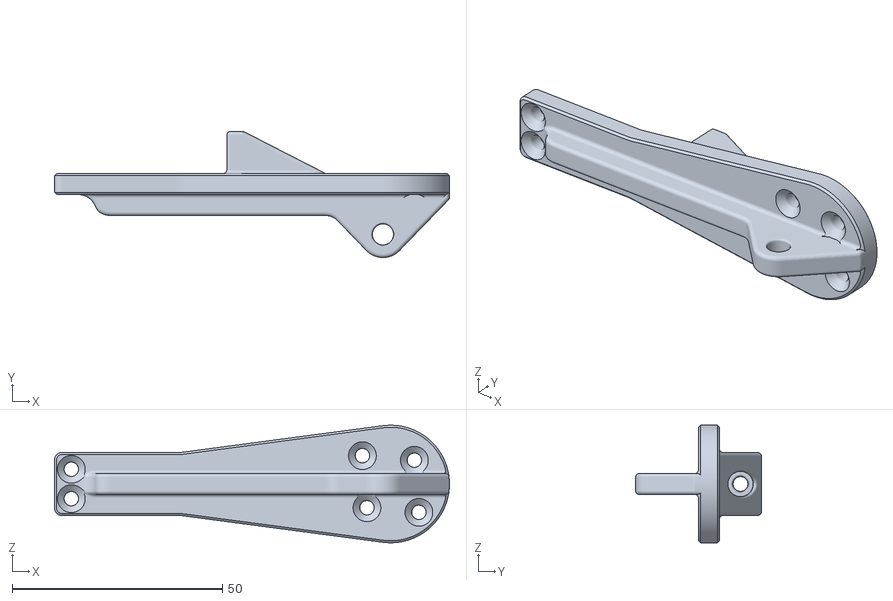
[picture p40: CAD file, 2025-02-20]
Mechanics/3D_model/Файлы печати/Ложечка.stl
94.0 x 30.0 x 28.0
