he-projectile/PID_controller/Mechanics/3D_model/Файлы печати/Скобка 1.stl

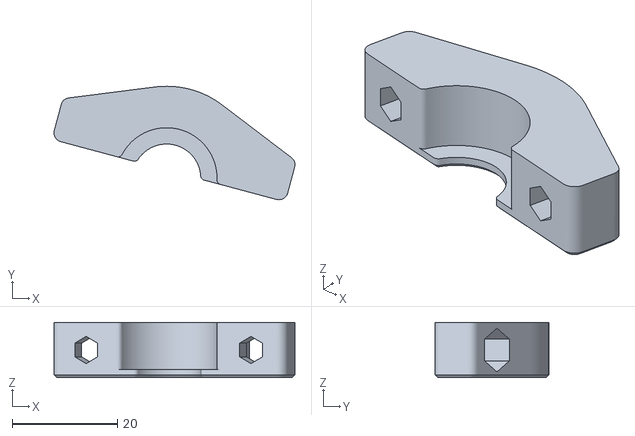
[picture p41: CAD file, 2025-01-01]
Mechanics/3D_model/Файлы печати/Скобка 1.stl
45.9 x 21.6 x 10.5
