he-projectile/PID_controller/Mechanics/3D_model/Файлы печати/Блок.stl

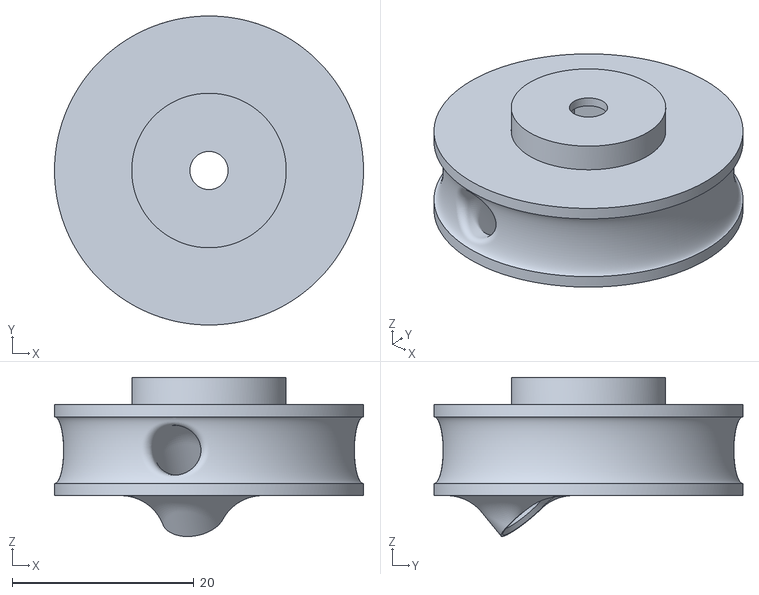
[picture p42: CAD file, 2025-01-01]
Mechanics/3D_model/Файлы печати/Блок.stl
34.0 x 34.0 x 17.5
