he-projectile/PID_controller/Mechanics/3D_model/Файлы печати/Вал насадка.stl

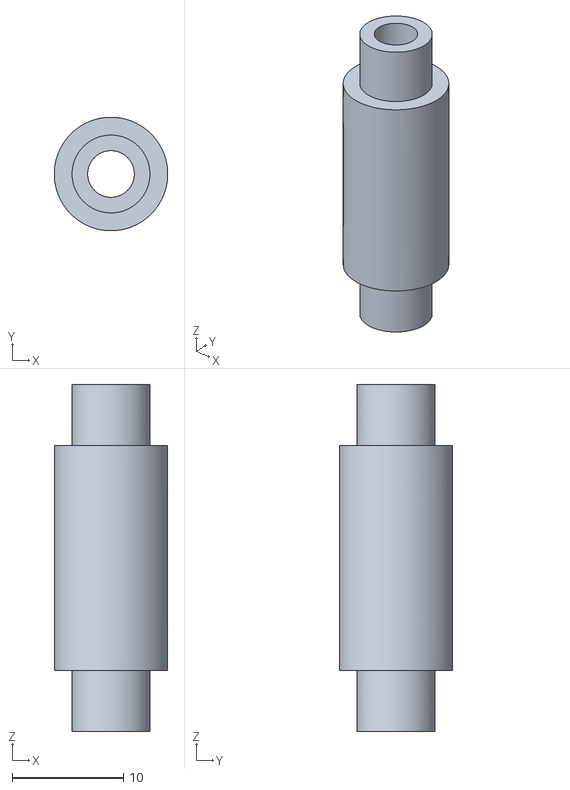
[picture p43: CAD file, 2024-12-10]
Mechanics/3D_model/Файлы печати/Вал насадка.stl
10.2 x 10.2 x 31.2
