he-projectile/PID_controller/Mechanics/3D_model/Файлы печати/Фланец.stl

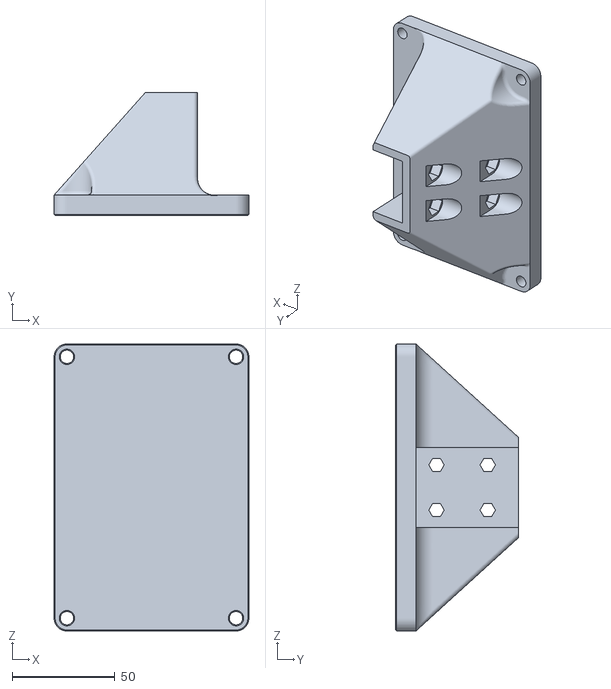
[picture p44: CAD file, 2024-12-09]
Mechanics/3D_model/Файлы печати/Фланец.stl
95.0 x 60.0 x 140.0
