he-projectile/PID_controller/Mechanics/3D_model/Файлы печати/Стрелочка.stl

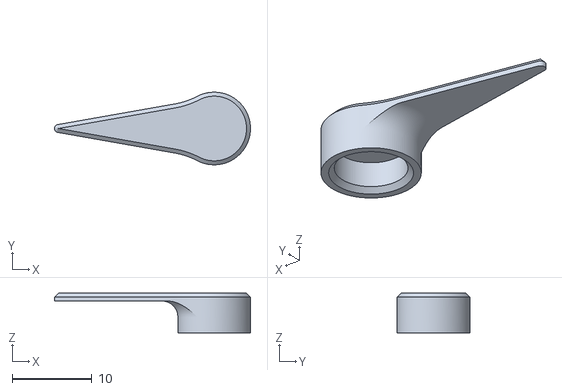
[picture p45: CAD file, 2024-11-30]
Mechanics/3D_model/Файлы печати/Стрелочка.stl
24.6 x 9.10 x 5.00
