he-projectile/PID_controller/Mechanics/3D_model/Файлы печати/Луч обрезанный.stl

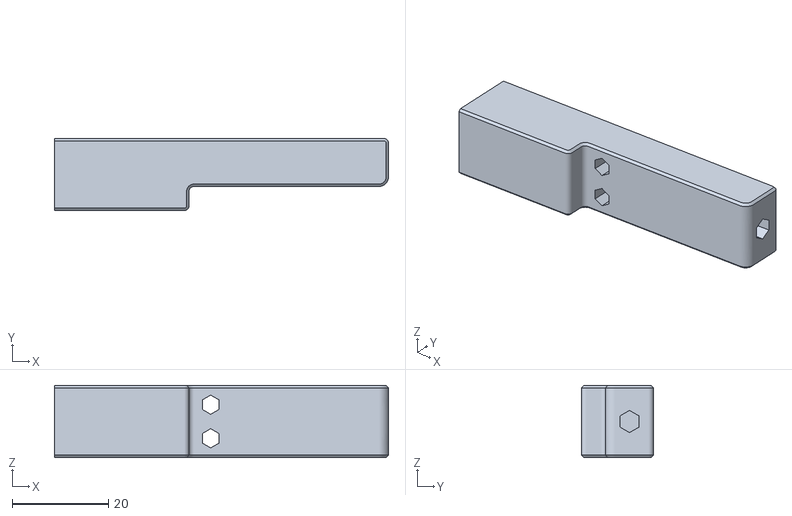
[picture p46: CAD file, 2024-11-26]
Mechanics/3D_model/Файлы печати/Луч обрезанный.stl
69.5 x 15.0 x 15.0
