he-projectile/PID_controller/Mechanics/3D_model/Файлы печати/Ножка 2 обрезанная.stl

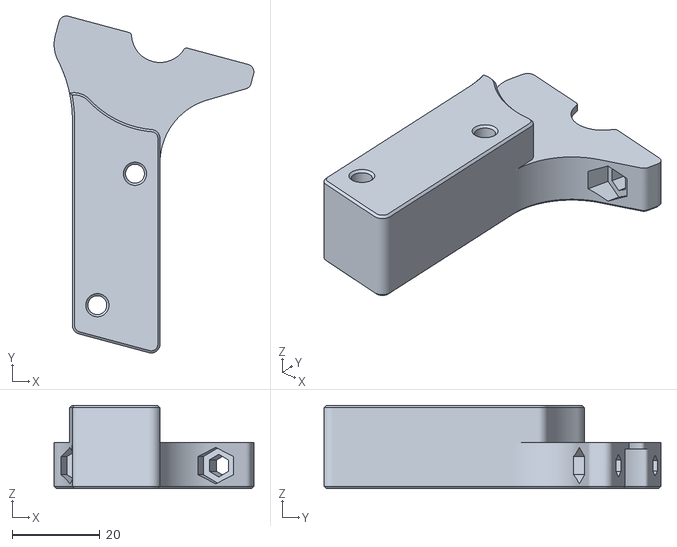
[picture p47: CAD file, 2024-11-25]
Mechanics/3D_model/Файлы печати/Ножка 2 обрезанная.stl
45.6 x 76.9 x 19.0
