he-projectile/PID_controller/Mechanics/3D_model/Файлы печати/Ноэка 1 обрезанная.stl

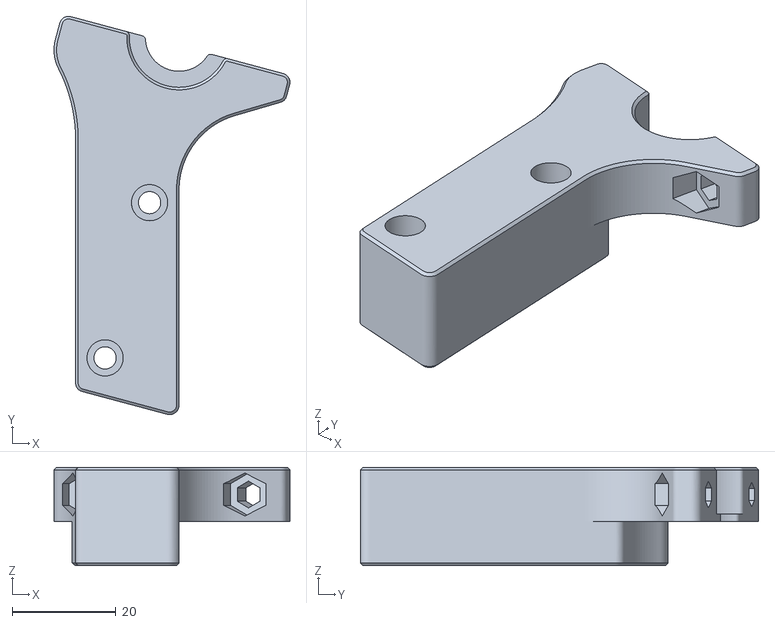
[picture p48: CAD file, 2024-11-25]
Mechanics/3D_model/Файлы печати/Ноэка 1 обрезанная.stl
45.6 x 77.0 x 19.0
