he-projectile/PID_controller/Mechanics/3D_model/Файлы печати/Ножка 1.stl

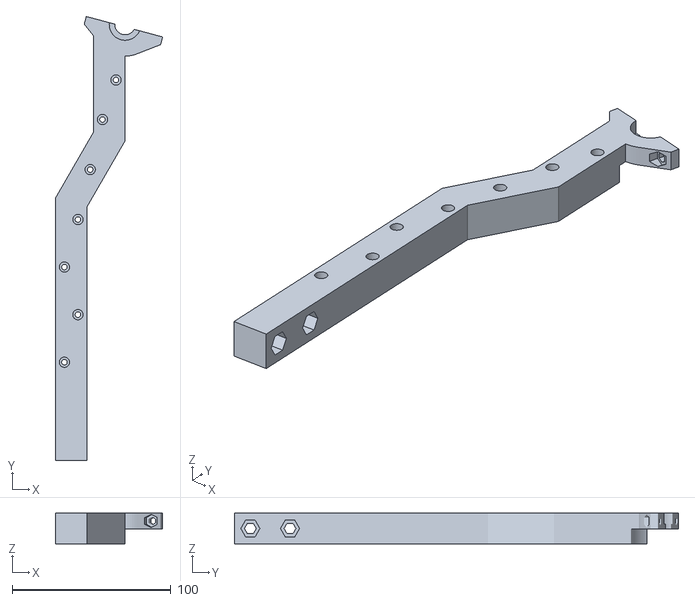
[picture p49: CAD file, 2024-11-21]
Mechanics/3D_model/Файлы печати/Ножка 1.stl
67.7 x 280.0 x 19.5
