he-projectile/PID_controller/(list of files, cad)

Other CAD files:
Mechanics/3D_model/MPU6050.ipt
Mechanics/3D_model/OldVersions/MPU6050.0007.ipt
Mechanics/3D_model/OldVersions/Вал насадка 1.0007.ipt
Mechanics/3D_model/OldVersions/Вал насадка 2.0001.ipt
Mechanics/3D_model/OldVersions/Вал стержень.0002.ipt
Mechanics/3D_model/OldVersions/Ложечка.0014.ipt
Mechanics/3D_model/OldVersions/Луч.0031.ipt
Mechanics/3D_model/OldVersions/Моторчик.0032.ipt
Mechanics/3D_model/OldVersions/Ножка 1.0019.ipt
Mechanics/3D_model/OldVersions/Ножка 2.0018.ipt
Mechanics/3D_model/OldVersions/Подшипник.0016.ipt
Mechanics/3D_model/OldVersions/Провеллер.0001.ipt
Mechanics/3D_model/OldVersions/Пропеллер.0027.ipt
Mechanics/3D_model/OldVersions/Сборка.0102.iam
Mechanics/3D_model/OldVersions/Скобка 1.0012.ipt
Mechanics/3D_model/OldVersions/Скобка 2.0009.ipt
Mechanics/3D_model/OldVersions/Стрелочка.0009.ipt
Mechanics/3D_model/OldVersions/Фланец.0009.ipt
Mechanics/3D_model/OldVersions/Хочу сделать айфичу вставки.0002.ipt
Mechanics/3D_model/Детали твёрдого тела/OldVersions/Блок.0009.ipt
Mechanics/3D_model/Детали твёрдого тела/OldVersions/Вал насадка 1.0023.ipt
Mechanics/3D_model/Детали твёрдого тела/OldVersions/Вал насадка 2.0003.ipt
Mechanics/3D_model/Детали твёрдого тела/OldVersions/Вал стержень.0008.ipt
Mechanics/3D_model/Детали твёрдого тела/OldVersions/Ложечка.0028.ipt
Mechanics/3D_model/Детали твёрдого тела/OldVersions/Луч.0060.ipt
Mechanics/3D_model/Детали твёрдого тела/OldVersions/Ножка 1.0028.ipt
Mechanics/3D_model/Детали твёрдого тела/OldVersions/Ножка 2.0026.ipt
Mechanics/3D_model/Детали твёрдого тела/OldVersions/Ножка левая верх.0011.ipt
Mechanics/3D_model/Детали твёрдого тела/OldVersions/Ножка левая низ.0011.ipt
Mechanics/3D_model/Детали твёрдого тела/OldVersions/Ножка правая верх.0011.ipt
Mechanics/3D_model/Детали твёрдого тела/OldVersions/Ножка правая верх.0012.ipt
Mechanics/3D_model/Детали твёрдого тела/OldVersions/Ножка правая низ.0011.ipt
Mechanics/3D_model/Детали твёрдого тела/OldVersions/Ножка правая низ.0013.ipt
Mechanics/3D_model/Детали твёрдого тела/OldVersions/Скобка 1.0024.ipt
Mechanics/3D_model/Детали твёрдого тела/OldVersions/Скобка 1.0025.ipt
Mechanics/3D_model/Детали твёрдого тела/OldVersions/Скобка 2.0020.ipt
Mechanics/3D_model/Детали твёрдого тела/OldVersions/Стрелочка.0001.ipt
Mechanics/3D_model/Детали твёрдого тела/OldVersions/Фланец.0023.ipt
Mechanics/3D_model/Детали твёрдого тела/Блок.ipt
Mechanics/3D_model/Детали твёрдого тела/Вал насадка 1.ipt
Mechanics/3D_model/Детали твёрдого тела/Вал стержень.ipt
Mechanics/3D_model/Детали твёрдого тела/Ложечка.ipt
Mechanics/3D_model/Детали твёрдого тела/Луч.ipt
Mechanics/3D_model/Детали твёрдого тела/Ножка 1.ipt
Mechanics/3D_model/Детали твёрдого тела/Ножка 2.ipt
Mechanics/3D_model/Детали твёрдого тела/Ножка левая верх.ipt
Mechanics/3D_model/Детали твёрдого тела/Ножка левая низ.ipt
Mechanics/3D_model/Детали твёрдого тела/Ножка правая верх.ipt
Mechanics/3D_model/Детали твёрдого тела/Ножка правая низ.ipt
Mechanics/3D_model/Детали твёрдого тела/Скобка 1.ipt
Mechanics/3D_model/Детали твёрдого тела/Скобка 2.ipt
Mechanics/3D_model/Детали твёрдого тела/Твёрдое тело.iam
Mechanics/3D_model/Детали твёрдого тела/Фланец.ipt
Mechanics/3D_model/Метизы/DIN 912 - M4 x 0,7 x 35 x 20.ipt
Mechanics/3D_model/Метизы/DIN 985 - M4.ipt
Mechanics/3D_model/Метизы/OldVersions/DIN 912 - M4 x 0,7 x 35 x 20.0001.ipt
Mechanics/3D_model/Метизы/OldVersions/Винт M3-6gx8 ГОСТ 11738-84.0001.ipt
Mechanics/3D_model/Метизы/OldVersions/Винт M4-6gx40 ГОСТ 1491-80.0001.ipt
Mechanics/3D_model/Метизы/Винт M3-6gx8 ГОСТ 11738-84.ipt
Mechanics/3D_model/Метизы/Винт M4-6gx40 ГОСТ 11738-84.ipt
Mechanics/3D_model/Метизы/Винт M4-6gx40 ГОСТ 1491-80.ipt
Mechanics/3D_model/Метизы/Гайка M4-6H ГОСТ 11860-85.ipt
Mechanics/3D_model/Метизы/Шайба A 4 ГОСТ 6958-78.ipt
Mechanics/3D_model/Метизы/Шайба У 4Л ГОСТ 6402-78.ipt
Mechanics/3D_model/Моторчик.ipt
Mechanics/3D_model/Подшипник.ipt
Mechanics/3D_model/Пропеллер.ipt
Mechanics/3D_model/Сборка.iam
Mechanics/3D_model/Стрелочка.ipt
Mechanics/3D_model/Твёрдое тело.ipt
Mechanics/3D_model/Тестер втулок.ipt
Mechanics/3D_model/Хочу сделать айфичу вставки.ipt
