he-projectile/PID_controller/MCU/PID_controller_demonstration/Core/Src/main.c

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
/* Includes ------------------------------------------------------------------*/
#include "main.h"
#include "dma.h"
#include "i2c.h"
#include "tim.h"
#include "usb_device.h"
#include "gpio.h"

/* USER CODE BEGIN Includes */
#include <stdio.h>
#include <string.h>
#include <math.h>
#include "MATRIX.h"
#include "MICROS.h"
#include "MPU6050.h"
#include "usbd_cdc.h"
#include "usbd_cdc_if.h"

#include "dsp/fast_math_functions.h"

/* USER CODE END Includes */


/* USER CODE BEGIN PV */


float ACx, ACy, ACz, GYx, GYy, GYz, GYxPrev, GYyPrev, GYzPrev, MAGx, MAGy, MAGz,
	accTotal, gyroTotal, magTotal, 
	beamAngle, beamAngleTau = 0.001;
uint8_t accGyroMagOverload;
const uint16_t PCazimuth = 345;

struct microsPeriod cyclePeriod = {0, 0}, accGyroPeriod = {0, 0}; 				

const uint16_t timMin = 12000, timMax = 24000, timSpan = timMax - timMin;
//float kp = 10, ki = 0.001, kd = 5, ks = 700;
float kp = 1.2964, ki = 2, kd = 0.1604, ks = 700;
float P = 0, I = 0, D = 0, S = 0;
float reqAngle = 90, error = 0;	
float Ilim = 2;
float Plim = 1;
float Dsigma = 45;
float PIDsumTau = 0.001, PIDsum = 0, PIDnormedKoef = 0, PIDsumTmp = 0, thrustPortion = 0;
float accWeight = 2e-04;

MPU6050_DATA_STRUCTURE MPU6050entity1 = {
	.i2cHandle = &hi2c1, .i2cAddress = 0x68<<1,
	.accRawDataBuffer = {0}, .gyroRawDataBuffer = {0},
	.MPU6050state = 0, .overload = 0,
	.accRequestPeriodUs = 10000, .gyroRequestPeriodUs = 2000,
	.accPrevRequestUs = 0, .gyroPrevRequestUs = 0,
	.filterTauUs = 1000, .accPrevFilterUs = 0, .gyroPrevFilterUs = 0,
	.processedDataReady = 0,
	.accDataRequest = 0, .gyroDataRequest = 0,
	.compensatorACx = {1, 0}, .compensatorACy = {1, 0}, .compensatorACz = {1, 0}, 
	.compensatorGYx = {1, 0}, .compensatorGYy = {1, 0}, .compensatorGYz = {1, 0}, 
	.ACx = 0, .ACy = 0, .ACz = 0, .GYx = 0, .GYy = 0, .GYz = 0
	#ifdef DEBUG	
	, .accMesCnt = 0, .gyroMesCnt = 0,.initMicros = 0
	#endif
};


#define RX_BUF_SIZE 64
const uint8_t RxBufSize = RX_BUF_SIZE;
uint8_t RxBuf[RX_BUF_SIZE], protectFromWrite = 0, RxPayload[RX_BUF_SIZE];

typedef enum{
	STAGE_DEINIT = 0,
	STAGE_WAITING_FOR_START,
	STAGE_PREPARING,
	STAGE_RUNNING,
	STAGE_STOPPING,
	STAGE_RESTART,
} STAGES;
STAGES stage;

typedef enum{
	COMMAND_NONE,
	COMMAND_RESTART,
	COMMAND_RUN,
	COMMAND_STOP,
	COMMAND_CHANGE_VALUE	
} COMMAND;
COMMAND command;

/* USER CODE END PV */

void SystemClock_Config(void);
/* USER CODE BEGIN PFP */
void transmitBasis(float* floatArray, uint64_t time, uint8_t overload);
void transmitBeamAngle(float angle, float P, float I, float D, uint64_t time);
void initState(struct matrix *basis, struct matrix *gravity, struct matrix* north);
void restoreVertical(struct matrix* bas, struct matrix* grav, struct matrix* acc);
void PID(uint64_t time);
/* USER CODE END PFP */

/**
  * @brief  The application entry point.
  * @retval int
  */
int main(void)
{
  /* MCU Configuration--------------------------------------------------------*/

  /* Reset of all peripherals, Initializes the Flash interface and the Systick. */
  HAL_Init();

  /* Configure the system clock */
  SystemClock_Config();

  /* Initialize all configured peripherals */
  MX_GPIO_Init();
  MX_I2C1_Init();
  MX_DMA_Init();
  MX_TIM4_Init();
  MX_USB_DEVICE_Init();
  MX_TIM3_Init();
  /* USER CODE BEGIN 2 */
	microsInit(&htim3, 72000000);	// start micros timer
	
	htim4.Instance->PSC = 5;
	htim4.Instance->ARR = 48000;
	htim4.Instance->CCR2 = 0;		
	HAL_TIM_PWM_Start(&htim4, TIM_CHANNEL_2);
//	HAL_Delay(1000);
//	htim4.Instance->CCR2 = 1000;
	
	// startup the sensor, assign pointers of ACC, GYRO, MAG and overload flag variables	
	MPU6050setup(&MPU6050entity1);
	
	struct matrix accVec,	gyroVec, magVec, rotMatrix, basis, gravityVec, northVec, velocityVec, coordinate, basisStep1, basisStep1Inv, plug, transitionMatrix;
	
	matrixZeroes(&accVec , 3, 1);
	matrixZeroes(&gyroVec , 3, 1);
	matrixZeroes(&magVec , 3, 1);
	matrixZeroes(&rotMatrix , 3, 3);
	matrixEye(&basis, 3);
	matrixZeroes(&gravityVec, 3,1);
	matrixZeroes(&northVec, 3, 1);
	matrixZeroes(&velocityVec, 3,1);
	matrixZeroes(&coordinate, 3, 1);
	matrixZeroes(&basisStep1, 3, 3);
	matrixZeroes(&basisStep1Inv, 3, 3);
	matrixZeroes(&plug, 3, 3);
	matrixZeroes(&transitionMatrix, 3, 3);
	
	matrixSE(&northVec, 0, 0, 1);
//	matrixRotZ(&northVec, PCazimuth);
	// indication before the ongoing calibration. Sensor should be kept still!
	HAL_Delay(500);
	for(uint8_t v = 0; v<10; v++){
		HAL_GPIO_TogglePin(LED_GPIO_Port, LED_Pin);
		HAL_Delay(150);
	}
	HAL_GPIO_WritePin(LED_GPIO_Port, LED_Pin, GPIO_PIN_RESET);
	HAL_Delay(1000);
	HAL_GPIO_WritePin(LED_GPIO_Port, LED_Pin, GPIO_PIN_SET);
	
	gyroMeasureOffset(&MPU6050entity1);
	microsStart(&accGyroPeriod);	
	htim4.Instance->CCR2 = 12000;
	
  /* USER CODE END 2 */

  /* Infinite loop */
  /* USER CODE BEGIN WHILE */
	
  while (1)
  {
		static float periodS;
		static uint32_t ledToggleCnt = 0;
		static uint8_t newAngleReady = 0;
			
		switch (stage){
			case STAGE_DEINIT:{
				initState(&basis, &gravityVec, &northVec);
				
				matrixCopy(&basis, &basisStep1);
				matrixInvOrth(&basisStep1, &basisStep1Inv);				
				stage = STAGE_WAITING_FOR_START;
			} break;
			case STAGE_WAITING_FOR_START:{
				if (HAL_GPIO_ReadPin(KEY_GPIO_Port, KEY_Pin) == GPIO_PIN_RESET)
					stage = STAGE_PREPARING;						
			} break;
			case STAGE_PREPARING:{
				static uint8_t isPreparing = 0;
				static uint64_t prepatingStartTime = 0;
				if ( isPreparing == 0){
					isPreparing = 1;
					prepatingStartTime = micros();
					htim4.Instance->CCR2 = 13050;
				}	
				else if (micros() - prepatingStartTime > 10000000){
					isPreparing = 0;
					stage = STAGE_RUNNING;		
				}
			} break;			
			case STAGE_RUNNING:{	
				if (newAngleReady){
					PID(micros());
					newAngleReady = 0;
				}
			} break;
			case STAGE_STOPPING:{
				static uint8_t isStopping = 0;
				static uint64_t stoppingTime = 0;
				if ( isStopping == 0){
					isStopping = 1;
					stoppingTime = micros();
				}	
				else if (micros() - stoppingTime > 10000){
					stoppingTime = micros();
					htim4.Instance->CCR2 -= 5;
				}
				if (htim4.Instance->CCR2 < 13050){
					stage = STAGE_WAITING_FOR_START;
					isStopping = 0;
				}
			} break;
			case STAGE_RESTART:{
				static uint8_t isRestarting = 0;
				static uint64_t restartingTime = 0;
				if ( isRestarting == 0){
					isRestarting = 1;
					htim4.Instance->CCR2 = 12000;
					restartingTime = micros();
				} else if (micros() - restartingTime > 10000000){
					isRestarting = 0;
					stage = STAGE_DEINIT;
				}
			}break;
		};
			
		MPU6050_cycle(&MPU6050entity1, micros());		
		
		if ( MPU6050_ACC_isReady(&MPU6050entity1) == 1 ){	
			matrixSE(&accVec, 0, 0, MPU6050entity1.ACx);
			matrixSE(&accVec, 1, 0, MPU6050entity1.ACy);
			matrixSE(&accVec, 2, 0, MPU6050entity1.ACz);
			accTotal = matrixVecLen(&accVec);
			
			matrixMultiply(&basis, &accVec, &accVec);
			restoreVertical(&basis, &gravityVec, &accVec);
			matrixSum(&accVec, &gravityVec, &accVec);						
		}

		if ( MPU6050_ACC_isReady(&MPU6050entity1) == 1 ){	
			matrixSE(&accVec, 0, 0, MPU6050entity1.ACx);
			matrixSE(&accVec, 1, 0, MPU6050entity1.ACy);
			matrixSE(&accVec, 2, 0, MPU6050entity1.ACz);
			accTotal = matrixVecLen(&accVec);
			
			matrixMultiply(&basis, &accVec, &accVec);
			restoreVertical(&basis, &gravityVec, &accVec);
			matrixSum(&accVec, &gravityVec, &accVec);						
		}
		
		
		
		if( MPU6050_GYRO_isReady(&MPU6050entity1) == 1){
			float GYxTmp, GYyTmp, GYzTmp;
			float beamAngleTmp;
			
			microsUpdate(&accGyroPeriod);
			periodS = (float) accGyroPeriod.period*1e-6;
			// Линейная интерполяция
			GYxTmp = (MPU6050entity1.GYx+GYxPrev)/2 * periodS;
			GYyTmp = (MPU6050entity1.GYy+GYyPrev)/2 * periodS;
			GYzTmp = (MPU6050entity1.GYz+GYzPrev)/2 * periodS;
			GYxPrev = MPU6050entity1.GYx;
			GYyPrev = MPU6050entity1.GYy;
			GYzPrev = MPU6050entity1.GYz;	
			
			matrixRot3D(&rotMatrix, GYxTmp, GYyTmp, GYzTmp);
			matrixMultiply(&basis, &rotMatrix, &basis);
			
			matrixMultiply(&basis, &basisStep1Inv, &transitionMatrix);
			beamAngleTmp = rad2deg*matrixRotMatrixRotAngle(&transitionMatrix);
			
			beamAngle = beamAngleTmp + 2.19; // 2.19 градусов - смещение свободно висящего луча
			newAngleReady = 1;
		}		
		
		transmitBeamAngle(beamAngle, P, I, D, micros());	
		
		if (protectFromWrite == 1){
			switch (RxBuf[0] - '0'){
				case 0:
					command = COMMAND_RUN;
					break;
				case 1:
					command = COMMAND_STOP;
					break;
				case 2:
					command = COMMAND_RESTART;
					break;
				case 3:
					command = COMMAND_CHANGE_VALUE;
					memcpy(RxPayload, RxBuf, strlen((char*)RxBuf));
					break;
			}
			protectFromWrite = 0;
		}
		
		if (command != COMMAND_NONE){
			switch (command){
				case COMMAND_NONE:
					break;
				case COMMAND_STOP:
					if (stage == STAGE_RUNNING)
						stage = STAGE_STOPPING;
					break;
				case COMMAND_RESTART:
					if (stage == STAGE_WAITING_FOR_START)
						stage = STAGE_RESTART;
					break;
				case COMMAND_RUN:
					if (stage == STAGE_WAITING_FOR_START)
						stage = STAGE_PREPARING;
					break;
				case COMMAND_CHANGE_VALUE:
					switch (RxPayload[1] - '0'){
						case 0:
							sscanf((char*)(RxPayload+2), "%f", &reqAngle);
							break;
						case 1:
							sscanf((char*)(RxPayload+2), "%f", &kp);
							break;
						case 2:
							sscanf((char*)(RxPayload+2), "%f", &ki);
							break;
						case 3:
							sscanf((char*)(RxPayload+2), "%f", &kd);
							break;
					}
					break;			
			}
			command = COMMAND_NONE;
		}
	
		if(ledToggleCnt == 10000){// I hope this can indicate the load of the CPU
				HAL_GPIO_TogglePin(LED_GPIO_Port, LED_Pin);	
				ledToggleCnt = 0;
		}
		ledToggleCnt++;

		microsUpdate(&cyclePeriod);		
    /* USER CODE END WHILE */

    /* USER CODE BEGIN 3 */
  }
  /* USER CODE END 3 */
}

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
/* USER CODE BEGIN 4 */
// this fcn is needed to orient the MPU sensor
void initState(struct matrix *basis, struct matrix *gravity, struct matrix* north){
	struct matrix	rotVec, Rinit, acc, imGravity, magInit;
	float c, s, lx, ly, lz, theta;
	uint8_t magCnt = 0;
	
	matrixZeroes(&rotVec, 3,1);
	matrixZeroes(&Rinit, 3,3);
	matrixZeroes(&acc, 3,1);
	matrixZeroes(&imGravity, 3,1);
	matrixZeroes(&magInit, 3, 1);
	// acquisition ACC meawurements
	for(uint8_t i = 0; i < 100; i++){
		
		while (MPU6050_ACC_isReady(&MPU6050entity1) == 0)
			MPU6050_cycle(&MPU6050entity1, micros());
			
		acc.arr[0] += MPU6050entity1.ACx;
		acc.arr[1] += MPU6050entity1.ACy;
		acc.arr[2] += MPU6050entity1.ACz;
	}
	//// vertical alignment
	matrixMultiplyByNumb(&acc, gravity, -0.01);
	imGravity.arr[2] = -matrixVecLen(gravity);
	matrixCross(gravity, &imGravity, &rotVec);
	matrixNormVec(&rotVec, &rotVec);
	
	theta = acosf(matrixDot(gravity, &imGravity)/(matrixVecLen(&imGravity)*matrixVecLen(gravity)));
	matrixRotArbVec(&Rinit, &rotVec, theta);
	
	matrixMultiply(&Rinit, basis , basis);
	matrixMultiply(basis, gravity, gravity);	
	
	//// azimuth alignment
/*	matrixMultiplyByNumb(&magInit, &magInit, (float) 1/magCnt);
	matrixMultiply(basis, &magInit, &magInit);	
	magInit.arr[2] = 0;
	matrixNormVec(&magInit, &magInit);
	theta = -matrixVecAzimuth(north, &magInit);
	
	matrixSE(&Rinit,	0,	0, cos(theta));
	matrixSE(&Rinit,	0,	1, -sin(theta));
	matrixSE(&Rinit,	0,	2, 0);
	matrixSE(&Rinit,	1,	0, sin(theta));
	matrixSE(&Rinit,	1,	1, cos(theta));
	matrixSE(&Rinit,	1,	2, 0);
	matrixSE(&Rinit,	2,	0, 0);
	matrixSE(&Rinit,	2,	1, 0);
	matrixSE(&Rinit,	2,	2, 1);	
	
	matrixMultiply(&Rinit, basis , basis);*/
}

// allign vertical orientation to mitigate drift of gyro sensors or after a loss of angles due to overload
void restoreVertical(struct matrix* bas, struct matrix* grav, struct matrix* acc){
	struct matrix	rotVec, Rinit;
	float accLen, angle;
	
	matrixZeroes(&rotVec, 3,1);
	matrixZeroes(&Rinit, 3,3);
	accLen = matrixVecLen(acc);
	
	if( accLen > 9 && accLen <  11){
		matrixCross(acc, grav, &rotVec);
		matrixNormVec(&rotVec, &rotVec);
		angle = -acos(-matrixDot(acc, grav)/(accLen*matrixVecLen(grav)));
//		if( angle < -0.03 || angle > 0.03){
			matrixRotArbVec(&Rinit, &rotVec, angle*accWeight);
			matrixMultiply(&Rinit, bas, bas);
//		}
	}
}

// transmits array of vectors and sensor overload flag to PC via COM
void transmitBasis(float* floatArray, uint64_t time, uint8_t overload){
	static uint64_t prewTime = 0;
	if(time - prewTime < 50000) return;
	
	uint8_t data[10];
	
	prewTime = time;
	for(uint8_t i = 0; i<9; i++){
		data[i] = (int8_t) (floatArray[i]*100);
	}
	data[9] = overload;
		
	CDC_Transmit_FS(data, 10);
}

void transmitBeamAngle(float angle, float P, float I, float D, uint64_t time){
	static uint64_t prewTime = 0;
	static uint8_t data[20];
	static uint8_t counter = 0;
	
	if(time - prewTime < 5000) return;
	angle = angle*200;
	data[1] = ((uint16_t)(angle)>>8)&0x00ff;
	data[0] = ((uint16_t)(angle))&0x00ff;
	P = P*1000;
	data[3] = ((uint16_t)(P)>>8)&0x00ff;
	data[2] = ((uint16_t)(P))&0x00ff;
	I = I*1000;
	data[5] = ((uint16_t)(I)>>8)&0x00ff;
	data[4] = ((uint16_t)(I))&0x00ff;
	D = D*1000;
	data[7] = ((uint16_t)(D)>>8)&0x00ff;
	data[6] = ((uint16_t)(D))&0x00ff;
	
	data[9] = ((uint16_t)(PIDsum*1000)>>8)&0x00ff;
	data[8] = ((uint16_t)(PIDsum*1000))&0x00ff;
//	counter ++;
	prewTime = time;
	CDC_Transmit_FS(data, 10);
	
//	if (counter == 10){
//		CDC_Transmit_FS(data, 20);
//		counter = 0;
//	}
}

void PID(uint64_t time){
	static uint64_t prewTime = 0;
	static uint64_t PIDperiod = 0;
	static float periodSPID;
	static uint8_t firstIteration = 1;
	static float anglePrev = 0, da = 0;
	static uint16_t cnt = 0;
	
	if (firstIteration){
		error = reqAngle - beamAngle;
		firstIteration = 0;
		anglePrev = beamAngle;
		prewTime = time;
		return;
	}
	
	PIDperiod = (time - prewTime);
//	if(PIDperiod < 1000) return;
	prewTime = time;
	
	cnt ++;
	
	if(cnt == 0xFFFF)
		return;
	
	periodSPID = 1.0e-6*PIDperiod;
	if (periodSPID > 1)
		return;
	
	error = reqAngle - beamAngle;
	S = +ks*sin(deg2rad*reqAngle);
	P = 	kp*deg2rad*error;
//	P = (P > Plim) ? Plim : P;
//	P = (P < -Plim) ? -Plim: P;
	I += 	ki*periodSPID*deg2rad*error;
	I = (I > Ilim) ? Ilim : I;
	I = (I < -Ilim) ? -Ilim: I;
	
	da = beamAngle-anglePrev;
	anglePrev = beamAngle;
	float DTmp = kd*deg2rad*da/periodSPID;
//	D = kd*da*fabs(da)/periodS * exp(-pow(error/Dsigma, 2));
	
//	if (da >= 0)
//		D = kd*da/periodS;
//	else 
//		D = kd*da/periodS * exp(-pow(error/Dsigma, 2));
	
	
//	PIDsumTmp = (P+I-D+S)/1000;	
	D = (fabs(D) < 1e-20) ? ((D>=0)? 1e-20 : -1e-20) : D; // защита от ошибки процессора
	float DnormedKoef = periodSPID/(PIDsumTau+periodSPID);
	D = DnormedKoef*DTmp+(1-DnormedKoef)*D;
	
	PIDsum = (P+I-D);
	
	PIDsum = (PIDsum > 1) ? 1 : PIDsum;
	PIDsum = (PIDsum < 0.1) ? 0.1 : PIDsum;
	
//	PIDsumTmp = (PIDsumTmp < 1e-20) ? 1e-20: PIDsumTmp; // защита от ошибки процессора
//	PIDnormedKoef = periodSPID/(PIDsumTau+periodSPID);
//	PIDsum = PIDnormedKoef*PIDsumTmp+(1-PIDnormedKoef)*PIDsum;
	


//	PIDsum = PIDsumTmp;
	
	thrustPortion = 3.88493*powf(PIDsum, 0.9859) -3.4705*PIDsum + 0.0306;
	
	htim4.Instance->CCR2 = (uint16_t)(thrustPortion * timSpan + timMin);
	
}


/* USER CODE END 4 */
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
