he-projectile/PID_controller/MCU/PID_controller_demonstration/PID_controller_demonstration.ioc

Mcu.UserName=STM32F411CEUx
PA0-WKUP.GPIO_Label=KEY
PA0-WKUP.Signal=GPXTI0
PA11.Signal=USB_OTG_FS_DM
PA12.Signal=USB_OTG_FS_DP
PA13.Signal=SYS_JTMS-SWDIO
PA14.Signal=SYS_JTCK-SWCLK
PB7.Signal=S_TIM4_CH2
PB8.Signal=I2C1_SCL
PB9.Signal=I2C1_SDA
PC13-ANTI_TAMP.GPIO_Label=LED
PC13-ANTI_TAMP.Signal=GPIO_Output
