he-projectile/PID_controller/MCU/PID_controller_demonstration/Core/Inc/main.h

#define LED_Pin GPIO_PIN_13
#define LED_GPIO_Port GPIOC
#define KEY_Pin GPIO_PIN_0
#define KEY_GPIO_Port GPIOA
#define KEY_EXTI_IRQn EXTI0_IRQn
