he-projectile/PID_controller/(commit log)

2024-11-10 Почти всё сделал
    [Ложечка.0001.ipt, Ложечка.ipt, Луч.0003.ipt, Луч.0005.ipt, Луч.ipt, Ножка 1.0005.ipt, Ножка 1.0007.ipt, Ножка 1.ipt]
2024-11-20 Сделать статичными не получилось, но скопировал архив
    [Сборка.0015.iam, Сборка.0017.iam, Сборка.iam]
2024-11-21 мёрдж удался
    [Ложечка.0001.ipt, Ложечка.0004.ipt, Ложечка.ipt, Ложечка.stl, Луч обрезанный.stl, Луч.0005.ipt, Луч.0014.ipt, Луч.ipt]
2024-11-21 проверил печать крепления подшипника. перемоделил ложечку, потренировался с айфичей. Сделал тестер для резьбовых вставок
    [Ложечка.0004.ipt, Ложечка.0008.ipt, Ложечка.ipt, Ложечка.stl, Луч.0014.ipt, Луч.0015.ipt, Луч.ipt, Моторчик.0001.ipt]
2024-11-24 немного поделал модельку. как будто бестолково
    [Вал насадка 1.0001.ipt, Вал насадка 1.ipt, Вал насадка 2.0001.ipt, Вал насадка 2.ipt, Вал стержень.0002.ipt, Вал стержень.ipt, Гайка M4-6H ГОСТ 11860-85.ipt, Ложечка.0008.ipt]
2024-11-25 вылощил узел оси. ридумал вал и насадку на него
    [Вал насадка 1.0001.ipt, Вал насадка 1.0007.ipt, Вал насадка 1.ipt, Вал насадка 1.stl, Вал насадка 2.ipt, Вал стержень.ipt, Луч обрезанный.stl, Луч.0021.ipt]
2024-11-25 не удержался и поредактировал ножки, чтобы выбрать крепёж
    [DIN 912 - M4 x 0,7 x 35 x 20.0001.ipt, DIN 912 - M4 x 0,7 x 35 x 20.ipt, DIN 985 - M4.ipt, Вал насадка 2.0002.ipt, Вал насадка 2.ipt, Вал стержень.0003.ipt, Вал стержень.ipt, Ножка 1.0016.ipt]
2024-11-25 проверил узел с валом. не понравилос. апечатал ещё
    [Вал насадка 1.0008.ipt, Вал насадка 1.ipt, Вал насадка 2.0002.ipt, Вал насадка 2.0003.ipt, Вал насадка 2.ipt, Вал стержень.0003.ipt, Вал стержень.0004.ipt, Вал стержень.ipt]
2024-11-26 получились нормальные ножки. правда не целиком. проверил интерфейс ложечки и луча. забыл поправить. поставил печататься луч целиком
    [Вал насадка 1.0008.ipt, Вал насадка 1.0010.ipt, Вал насадка 1.ipt, Вал насадка 2.ipt, Вал насадка.stl, Ложечка.ipt, Луч обрезанный.stl, Луч.0025.ipt]
2024-11-28 утилизирую остатки пластика, печатаю фланец
    [Твёрдое тело.0116.ipt, Твёрдое тело.0118.ipt, Твёрдое тело.ipt, Фланец.0011.ipt, Фланец.ipt, Фланец.stl]
2024-11-29 сделал стрелочку. Усилил крепление скоб. разрешал конфликты с гитом
    [PID_demensions.xlsx, Вал насадка 1.0010.ipt, Вал насадка 1.0011.ipt, Вал насадка 1.ipt, Винт M4-6gx40 ГОСТ 11738-84.ipt, Ложечка.0015.ipt, Ложечка.ipt, Луч.0033.ipt]
2024-11-30 доделал стрелочку ещё раз
    [Вал насадка 1.0011.ipt, Вал насадка 1.0012.ipt, Вал насадка 1.ipt, Ложечка.0015.ipt, Ложечка.0016.ipt, Ложечка.ipt, Луч.0033.ipt, Луч.0034.ipt]
2024-12-01 неужели закончил модельку
    [Блок.0001.ipt, Блок.ipt, Вал насадка 1.0012.ipt, Вал насадка 1.0014.ipt, Вал насадка 1.ipt, Вал стержень.0004.ipt, Вал стержень.0006.ipt, Вал стержень.ipt]
2024-12-02 проверил блок. поставил печататься ножки
    [Блок.stl, Моторчик.0007.ipt, Моторчик.0008.ipt, Моторчик.ipt, Ножка 1.0026.ipt, Ножка 1.0027.ipt, Ножка 1.ipt, Ножка 2.0024.ipt]
2024-12-09 добавил в луч прорези для стаяжек. ереместил датчик
    [Блок.0001.ipt, Блок.0002.ipt, Блок.ipt, Вал насадка 1.0014.ipt, Вал насадка 1.0015.ipt, Вал насадка 1.ipt, Вал стержень.0006.ipt, Вал стержень.0007.ipt]
2024-12-10 справил поломавшиеся связи компонентов. Сделал спецификацию
    [Блок.0002.ipt, Блок.0003.ipt, Блок.ipt, Винт M3-6gx8 ГОСТ 11738-84.ipt, Винт M4-6gx40 ГОСТ 1491-80.ipt, Луч.0040.ipt, Луч.0042.ipt, Луч.ipt]
2024-12-10 увеличил насадку на стержень. поменял пару крепежей, чтобы было проще купить
    [Вал насадка 1.0015.ipt, Вал насадка 1.0017.ipt, Вал насадка 1.ipt, Вал насадка 1.stl, Вал насадка.stl, Ножка левая низ.0002.ipt, Ножка левая низ.0003.ipt, Ножка левая низ.ipt]
2024-12-19 обновил стлки для нескольких деталей
    [Блок.stl, Скобка 1.stl, Твёрдое тело.0171.ipt, Твёрдое тело.0172.ipt]
2024-12-19 исправил маленький недочёт
    [Твёрдое тело.0172.ipt]
2024-12-24 сделал подстраиваемую ножку
    [Ножка левая верх.0004.ipt, Ножка левая верх.ipt, Ножка левая верх.stl, Ножка левая низ.stl, Ножка правая верх.stl, Ножка правая низ.0003.ipt, Ножка правая низ.0005.ipt, Ножка правая низ.0006.ipt]
2025-01-01 подготовил проект в кубе. Поработал в матлабе, придумал, как вычислить вектор - ось вращения. Проверил, как определяется косая установка и падение
2025-01-01 чёто поломалось в гите
2025-01-03 поработал в матлабе. Научился определять угол оси вращения. научился определять угол отклонения луча. Научился детектировать падение вбок. Научился рисовать stl модель
    [stand.stl, Блок.0003.ipt, Блок.0004.ipt, Блок.ipt, Вал насадка 1.0017.ipt, Вал насадка 1.0018.ipt, Вал насадка 1.ipt, Вал стержень.0007.ipt]
2025-01-04 Ну так поправил чуть-чуть код в матлабе
2025-01-17 Судорожно наводил красоту
    [Блок.0004.ipt, Блок.0005.ipt, Блок.ipt, Вал насадка 1.0018.ipt, Вал насадка 1.0019.ipt, Вал насадка 1.ipt, Ложечка.0020.ipt, Ложечка.0021.ipt]
2025-01-18 Готовился к доду. Почему-то плохо работает гироскоп. Кажется, проблема в таймере. Не разобрался. Походу просто отключил его
2025-01-28 Начал думать над ограничителем
2025-01-31 сделал модель пид регулятора в матлабе. Это оказалось чуть проще, чем я ожидал
2025-02-13 переделал луч
    [Луч.0047.ipt, Луч.0050.ipt, Луч.ipt, Луч.stl, Ножка левая верх.0006.ipt, Ножка левая верх.0007.ipt, Ножка левая верх.ipt, Ножка правая верх.0005.ipt]
2025-02-20 Фух доделал красивую модельку
    [Блок.0005.ipt, Блок.0006.ipt, Блок.ipt, Вал насадка 1.0019.ipt, Вал насадка 1.0021.ipt, Вал насадка 1.ipt, Вал насадка 1.stl, Ложечка.0021.ipt]
2025-03-24 Ну всё, оно работает. Осталось сделать интерфейс и зазиту от дурака
2025-07-08 делаю статью
    [MPU6050.0001.ipt, MPU6050.ipt, Блок.0006.ipt, Блок.0007.ipt, Блок.ipt, Вал насадка 1.0021.ipt, Вал насадка 1.0022.ipt, Вал насадка 1.ipt]
2025-07-20 активно пишу статью. Разобрался с моделью динамики
    [MPU6050.0001.ipt, MPU6050.0007.ipt, MPU6050.ipt, PID_demensions.xlsx, Блок.0007.ipt, Блок.0009.ipt, Блок.ipt, Вал насадка 1.0022.ipt]
2025-08-30 начал делать приложение
2025-09-21 Начинаю красиво оформлять код
2025-09-21 Начинаю красиво оформлять код. Убрал большие файлы
2025-09-21 Переписал работу с датчиком
